lbalucos/Wilamp_DCU/mft/pcb/Controlled impedance/Top90.PNG

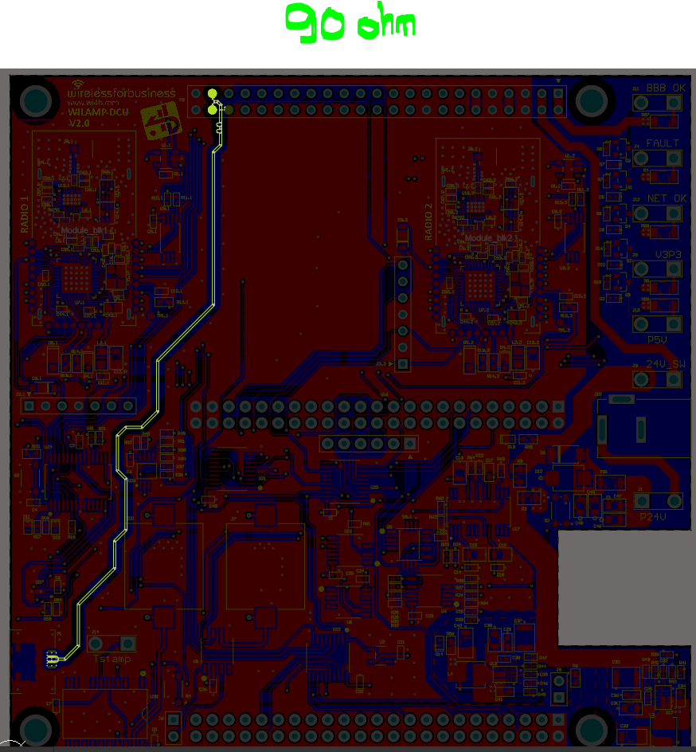
mft/pcb/Controlled impedance/Top90.PNG
