lbalucos/Wilamp_DCU/(threads)

Thread 1 (2022-04-07):

HW_CR1: remove components

lbalucos, 2022-04-07:
For the next batch we will not mount these components (we do not find equivalent):

- ATAES132A-SHER-B
- 24LC256T-I/SN
- ATECC108A-SSHDA
- AT97SC3205T-X3A1C-10

lbalucos, 2022-04-08:
-ATAES132A-SHER-B set as DNP
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

-24LC256T-I/SN set as DNP
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

-ATECC108A-SSHDA set as DNP
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

-AT97SC3205T-X3A1C-10 set as DNP
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

-MCP9808T-E/MS set as DNP
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

-24LC32AT-I/OT set as DNP
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

-PCF2129AT/2,518 set as DNP
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

Thread 2 (2022-04-07):

HW_CR2: find ALT PN on all components used

lbalucos, 2022-04-07:
For all the others components it is necessary to find an alternative, or the device will not work!

arthur-asodisen, 2022-04-16:
What is the kind of help needed?

lbalucos, 2022-04-18:
i need help finding alternate MPNs on some of the components
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

[Wilamp DCU ALT MPN (no DNP).xlsx](https://github.com/lbalucos/Wilamp_DCU/files/8506817/Wilamp.DCU.ALT.MPN.no.DNP.xlsx)

lbalucos, 2022-04-22:
NUD3124LT1G labeled as no stock

[Wilamp DCU ALT MPN (no DNP).xlsx](https://github.com/lbalucos/Wilamp_DCU/files/8541909/Wilamp.DCU.ALT.MPN.no.DNP.xlsx)

arthur-asodisen, 2022-04-22:
Ilist ang mga nakitan nimo nga alt parts para diretso rako check. Limitwd
kaayo akong time.

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

Thread 3 (2022-04-07):

HW_CR3: PCB Form factor, Header/connector position fixed

lbalucos, 2022-04-07:
Starting from the latest version released:
**Wilamp_DCU_v1.1 rls 20190123**
keeping the same PCB form factor and position of the headers and connectors, as a first step we require

Thread 4 (2022-04-07):

HW_CR4: replace the JN5168-M06 modules with the JN5169 chip

lbalucos, 2022-04-07:
- replace the JN5168-M06 modules with the JN5169 chip and the other necessary boundary components directly on the PCB, as done for the WiSZ and in the DCU_CM4_DINRAIL project. Maintains the u.FL connector for external antenna connection.

lbalucos, 2022-04-12:
JN5168-M06 module replaced with JN5169 chip
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

arthur-asodisen, 2022-04-16:
What kind of help needed?

lbalucos, 2022-04-18:
mislabeled, it should be for review only.

latest PCB update
Routing Complete
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

Thread 7 (2022-04-07):

HW_CR7:  JN5168 module #3 and all its components can be put in DNP or removed

lbalucos, 2022-04-07:
In this revision the JN5168 module #3 and all its components can be put in DNP.
Then in subsequent releases, if space is needed on the PCB in order to add other equivalent components with a larger package
or to have space to house the double footprint of critical components, to have more chances to find them in stock, we can remove the Module #3.

lbalucos, 2022-04-08:
Jennic 3 components marked as DNP
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

lbalucos, 2022-04-12:
Jennic module 3 removed since there is no space for traces
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
