lbalucos/Wilamp_DCU/pdf/Wilamp DCU v2.0.pdf

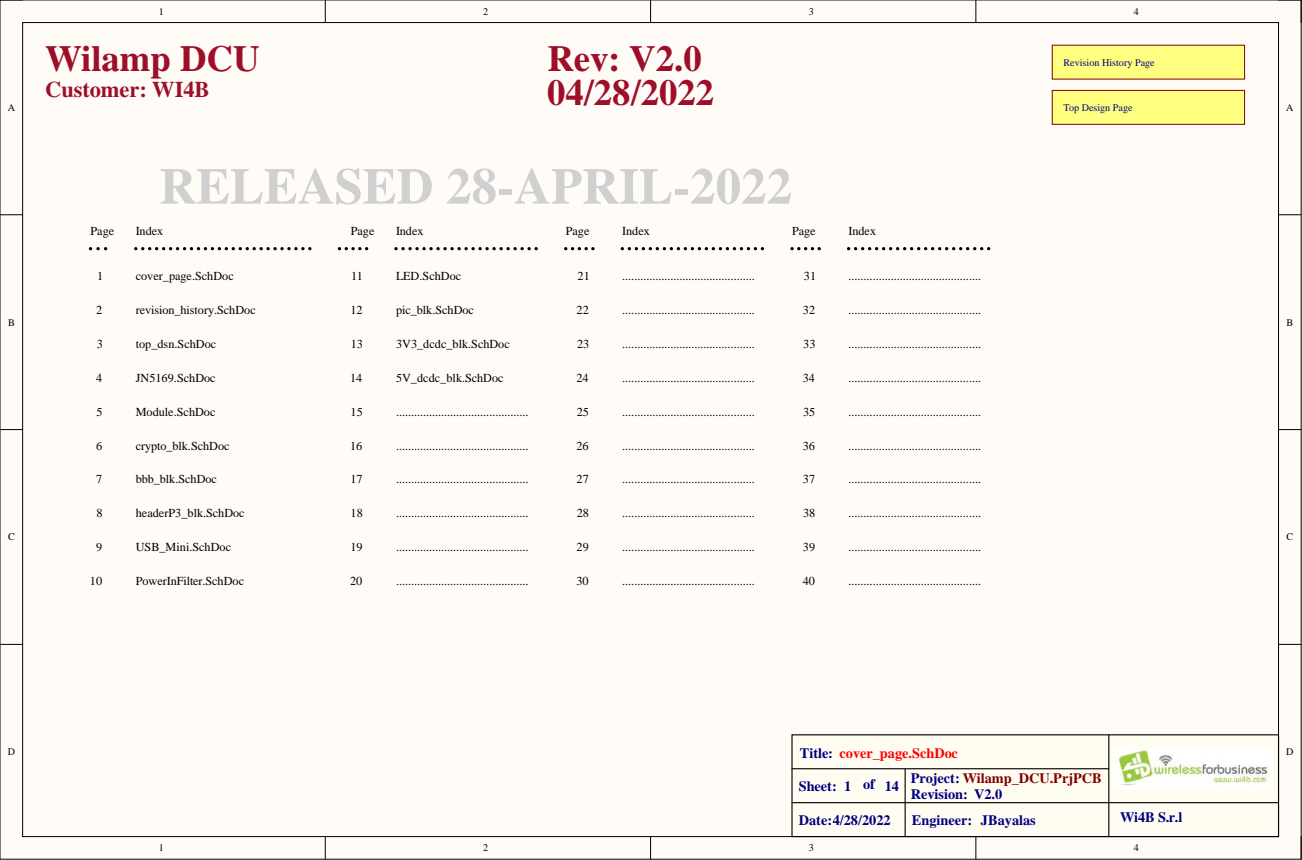
[picture p2: page 1]

Title: cover_page.SchDoc

Sheet: 1 of 14 | Project: Wilamp_DCU.PrjPCB Revision: V2.0

Date:4/28/2022 | Engineer: JBayalas | Wi4B S.r.l

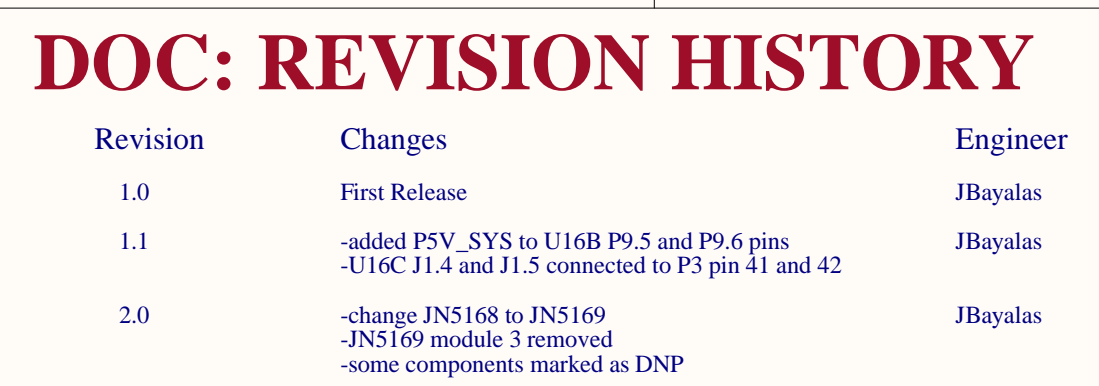
[picture p3: page 2]

-U16C J1.4 and J1.5 connected to P3 pin 41 and 42

-some components marked as DNP

Title: revision_history.SchDoc

Sheet: 2 of 14 | Project: Wilamp_DCU.PrjPCB Revision: V2.0

JBayalas

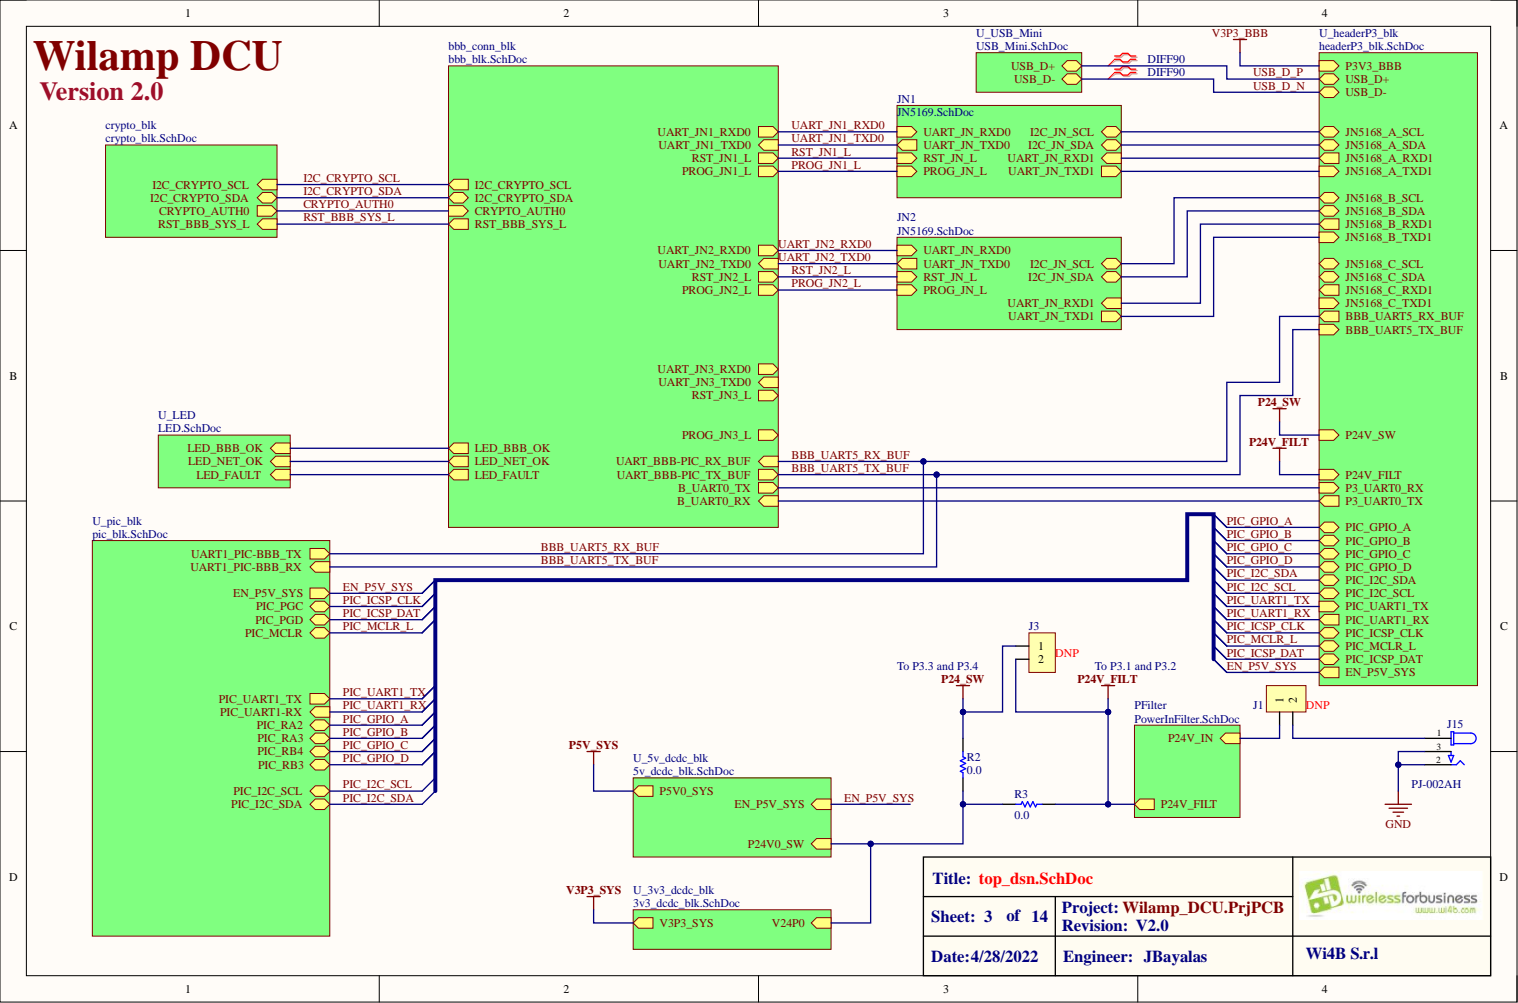
[picture p4: page 3]

UA RT_BBB-PIC_TX_BUF | BBB_UA RT5_TX_BUF

o f 14 Sheet: 3 | Project: Wilamp_DCU.PrjPC B Revision : V2.0

JBayal a s

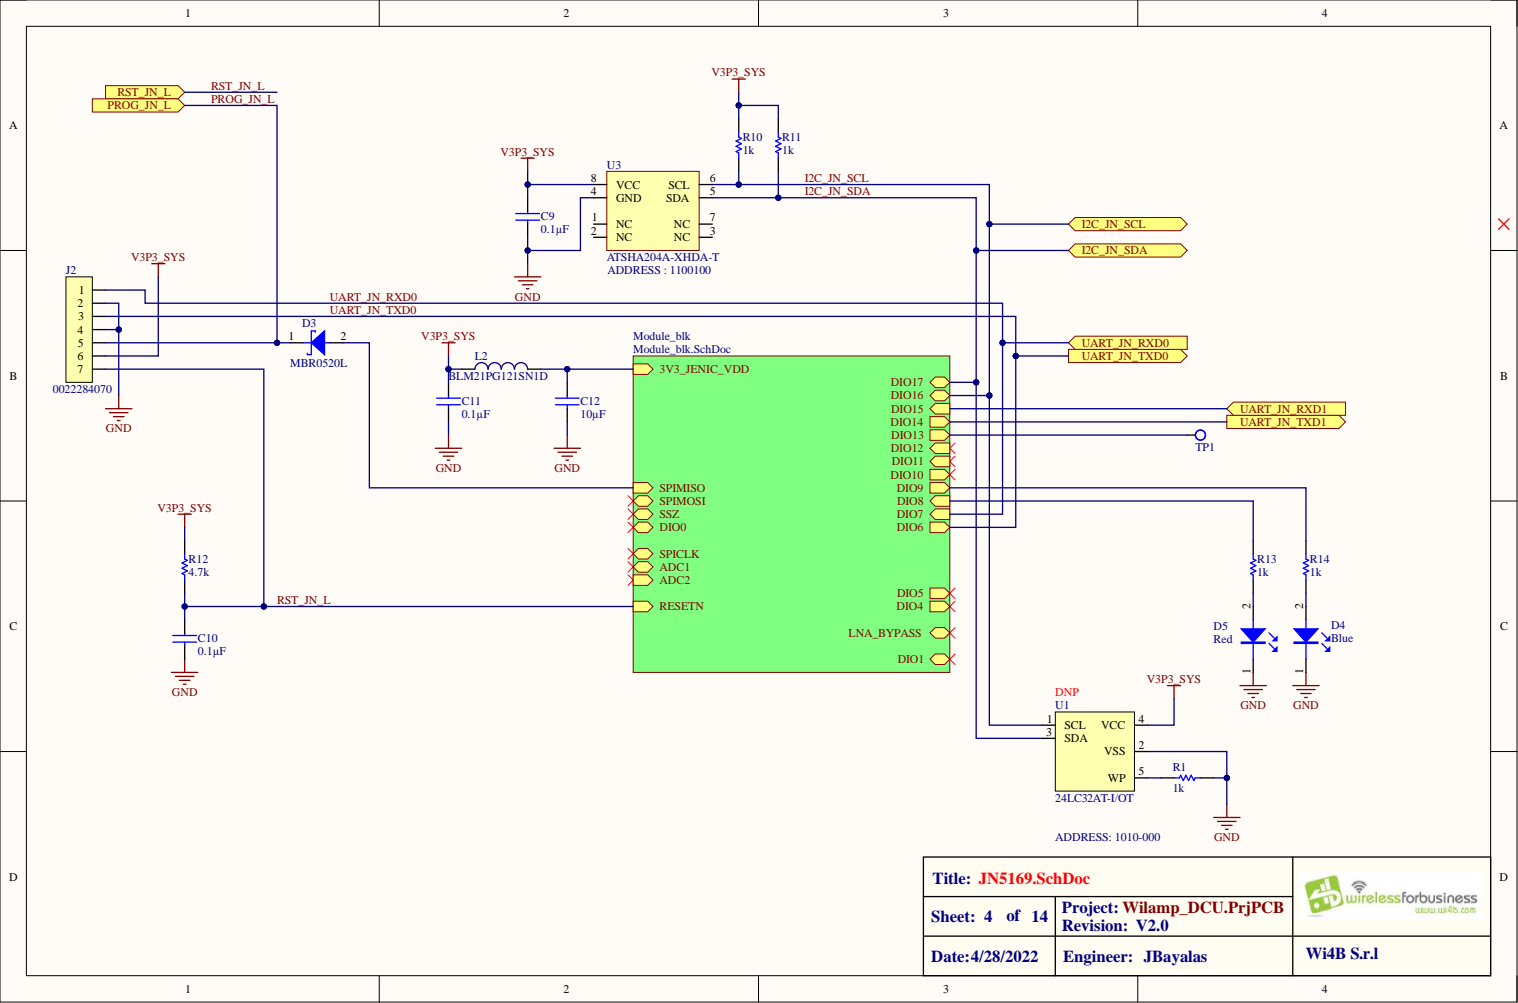
[picture p5: page 4]

I2C_JN_SDA

UART_JN_TXD0
D3

Title: JN5169.SchDoc

Sheet: 4 of 14 | Project: Wilamp_DCU.PrjPCB Revision: V2.0

JBayalas

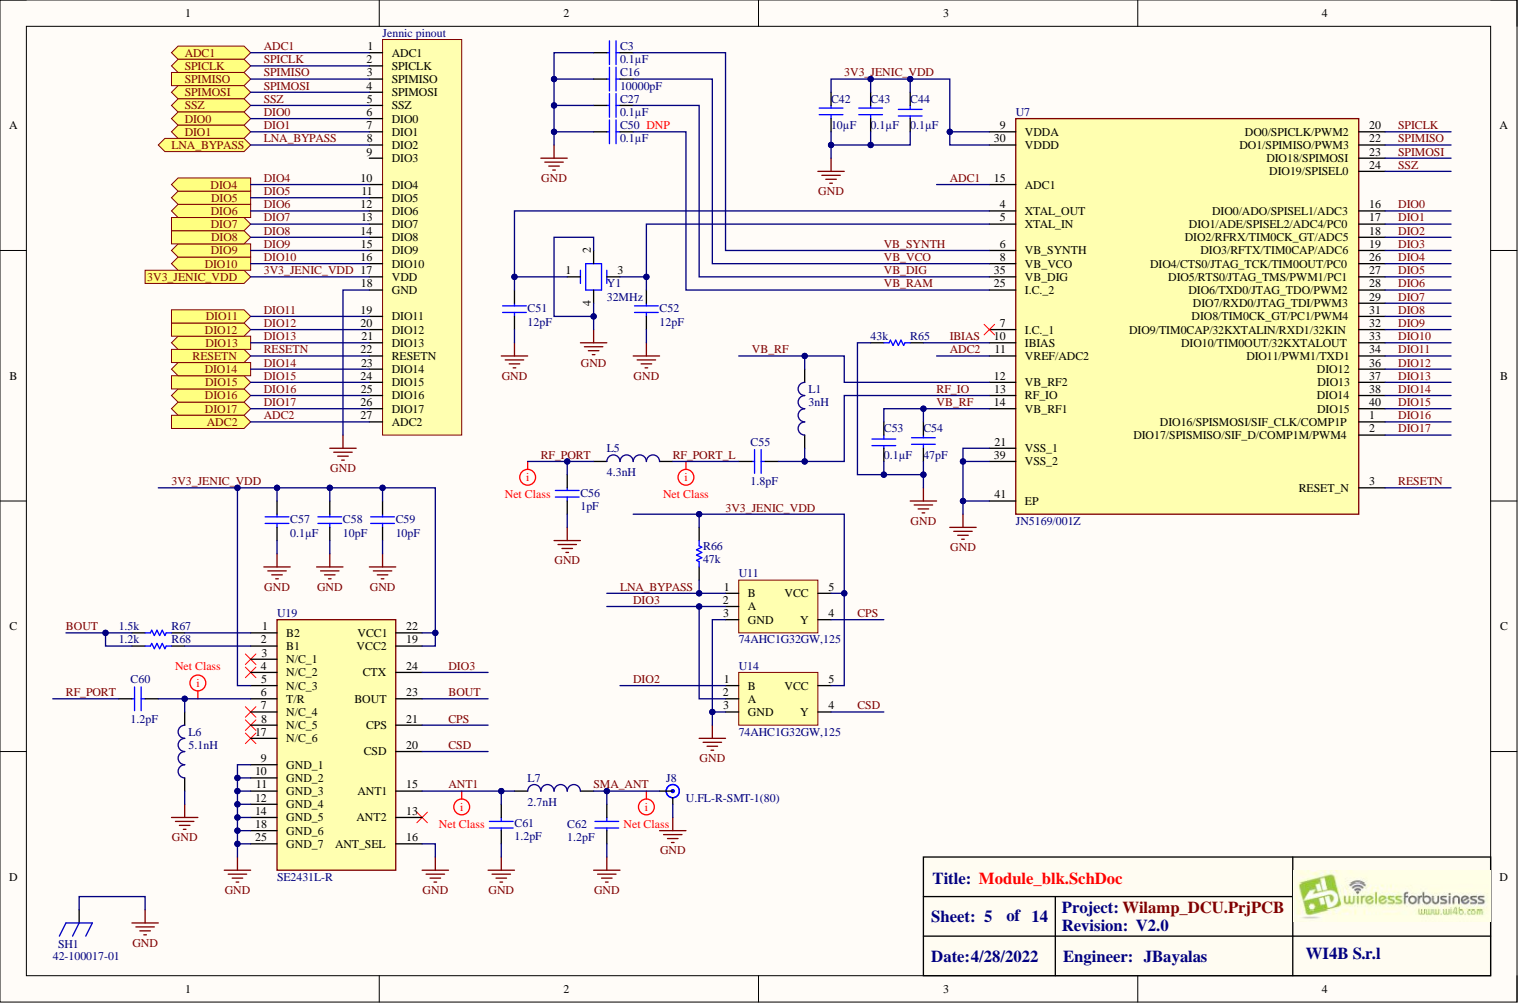
[picture p6: page 5]

0.1 C16 | µ F 3V3_JENIC_VDD

RESETN SPICLK SPIMISO SPIMOSI SSZ

Title: Module_blk.SchD o c

o f 14 Sheet: 5 | Project: Wilamp_DCU.PrjPC B

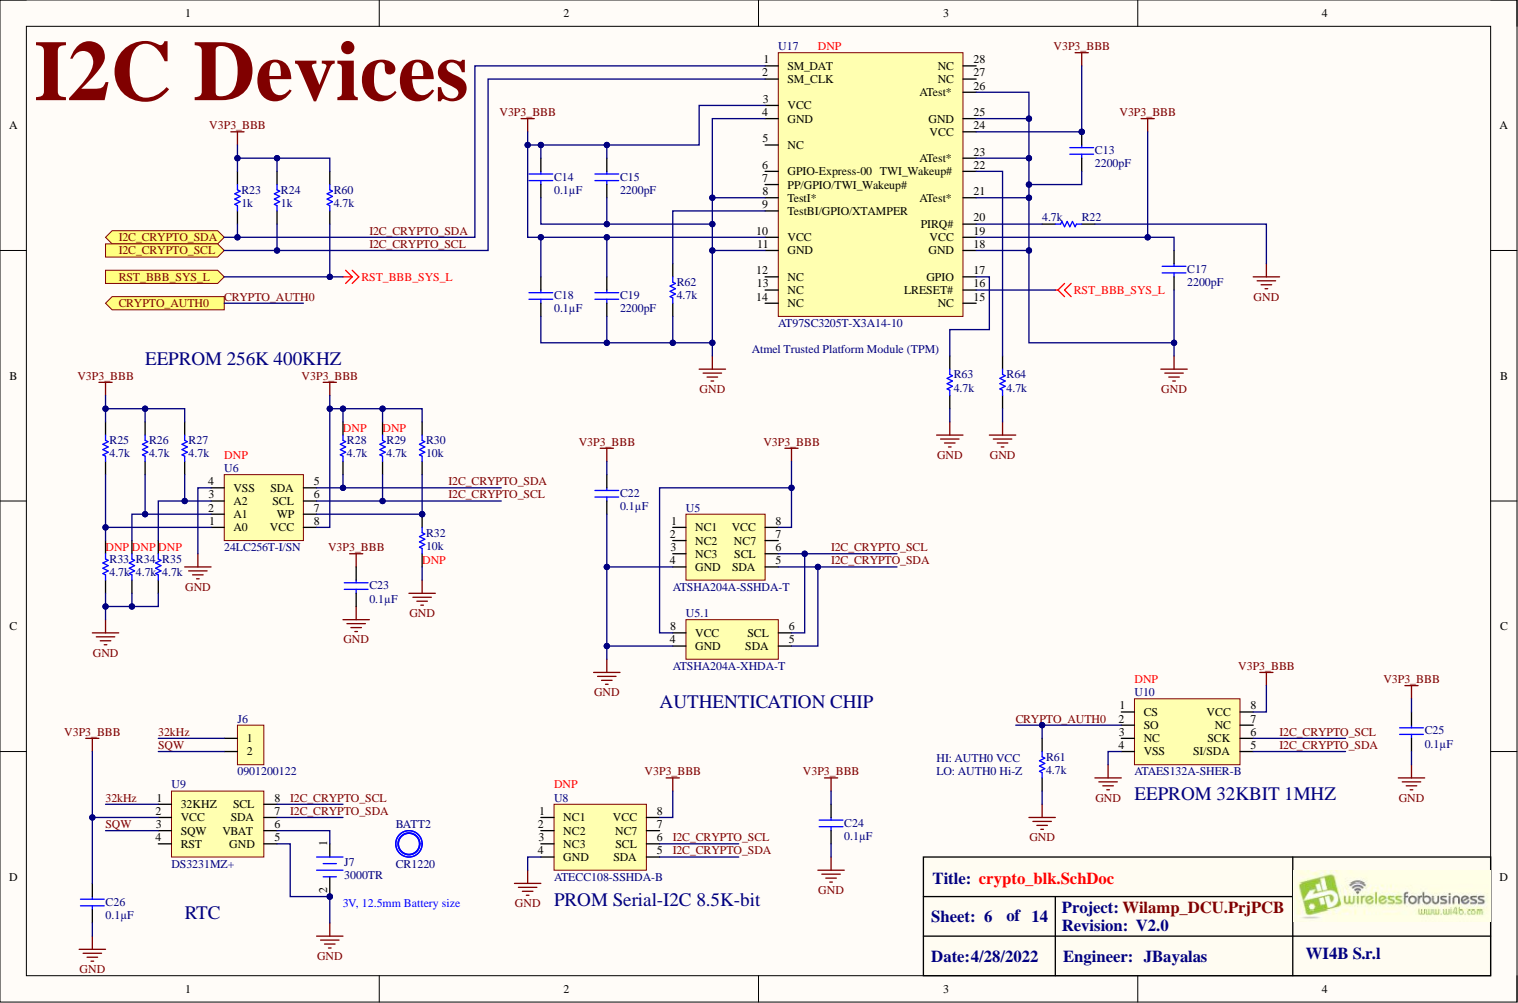
[picture p7: page 6]

Atmel Trusted Platform Module (TPM)

Title: crypto_blk.SchD o c

o f 14 Sheet: 6 | Project: Wilamp_DCU.PrjPC B

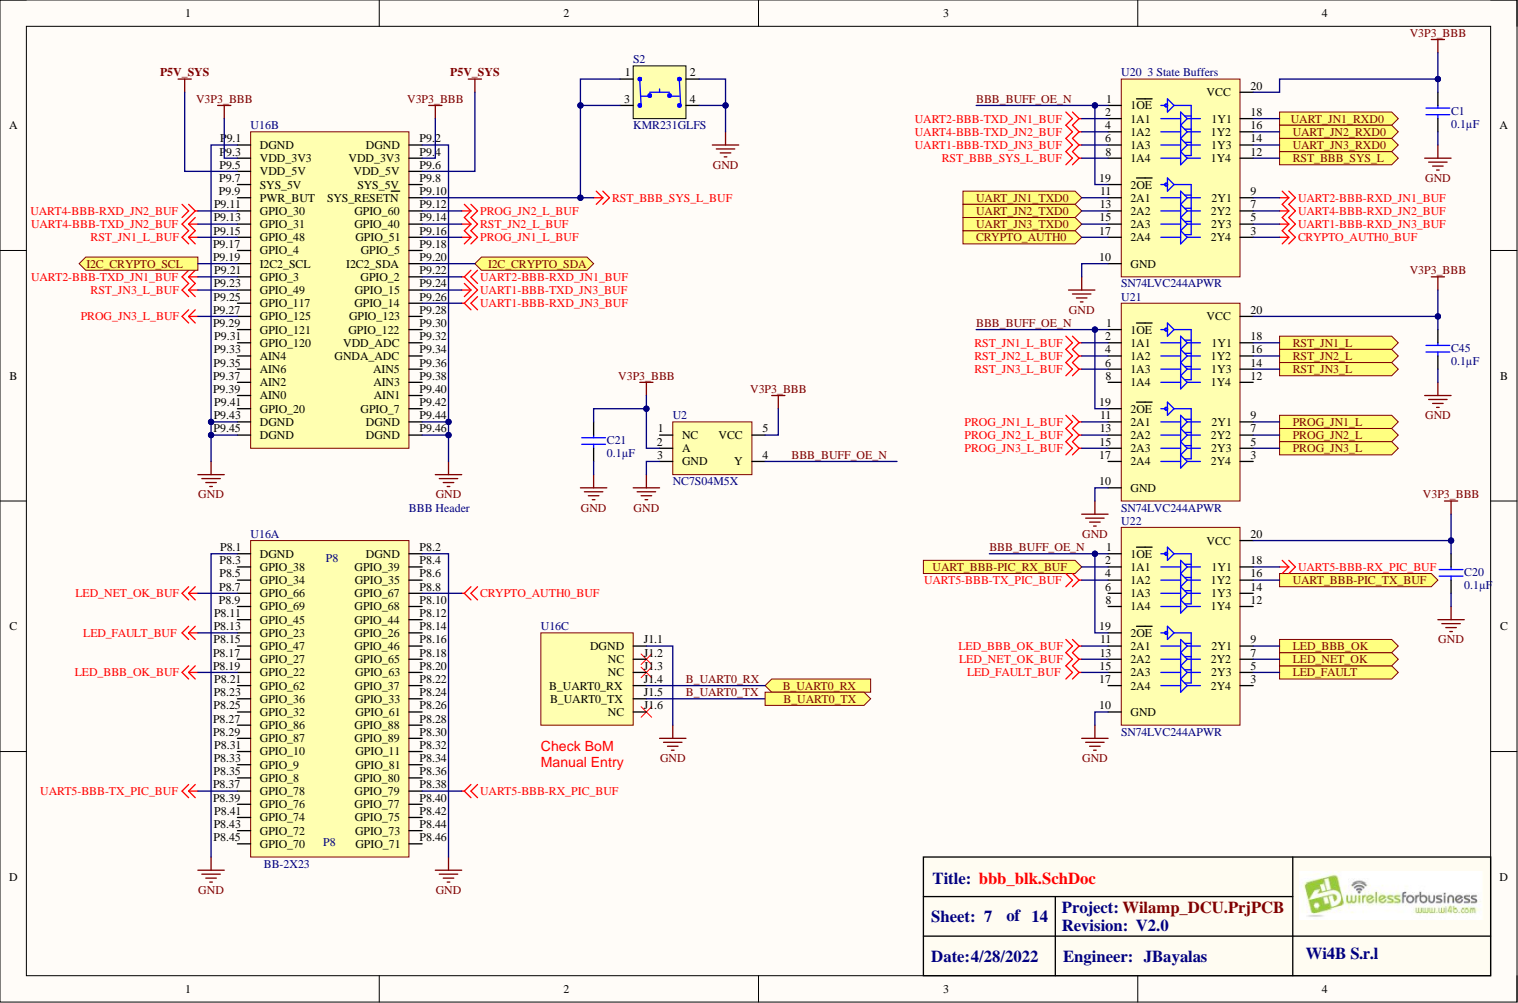
[picture p8: page 7]

1A2 4
1A3 6
1A4 8

Title: bbb_blk.SchDoc

Sheet: 7 of 14 | Project: Wilamp_DCU.PrjPCB Revision: V2.0

JBayalas

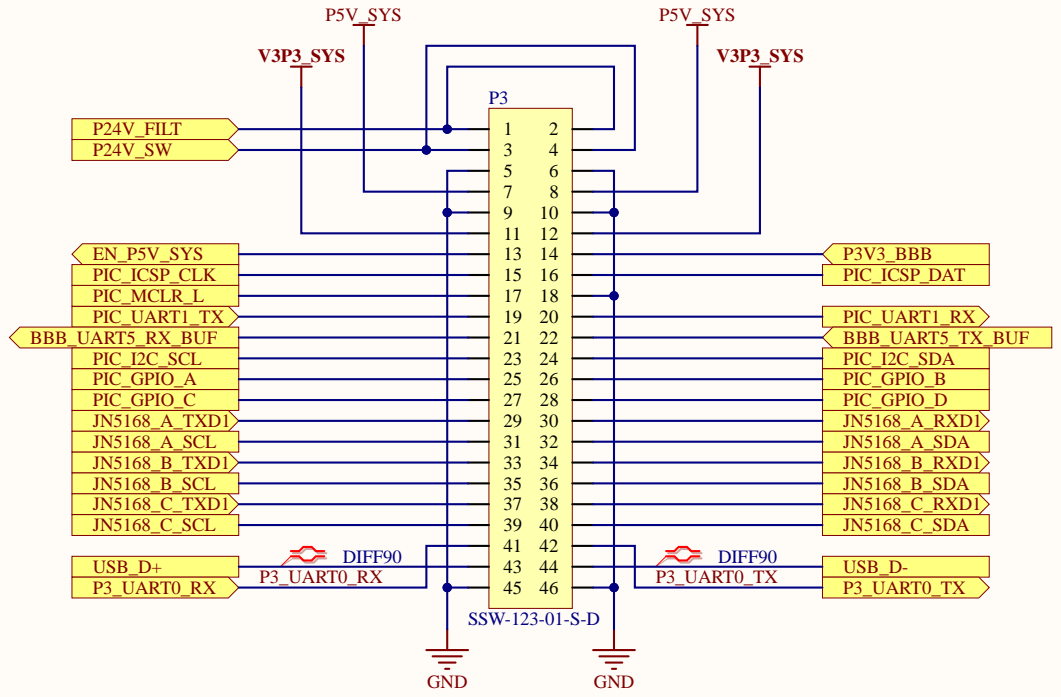
[picture p9: page 8]

DIFF90 | DIFF90

Title: headerP3_blk.SchDo c

o f 14 Sheet: 8 | Project: Wilamp_DCU.PrjPC B

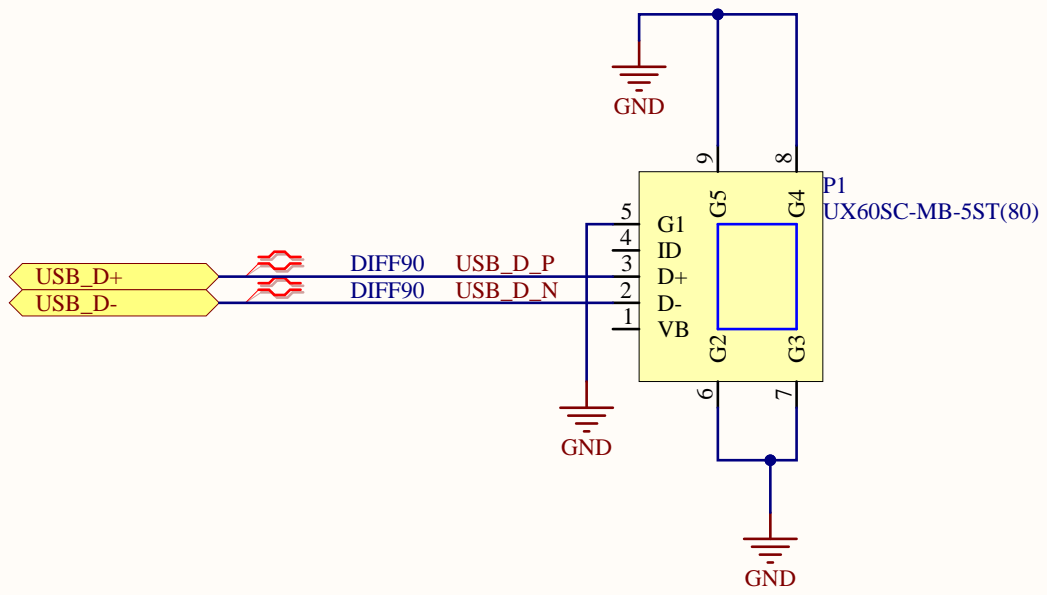
[picture p10: page 9]

Title: USB_Mini.SchD o c

o f 14 Sheet: 9 | Project: Wilamp_DCU.PrjPC B

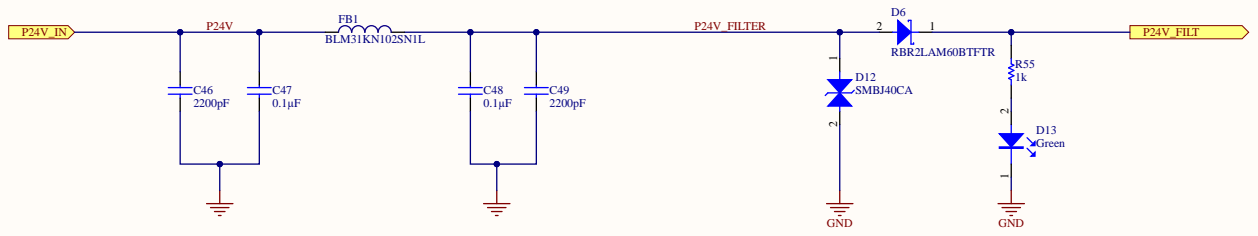
[picture p11: page 10]

Title: PowerInFilter.SchD o c

o f 14 Sheet: 10 | Project: Wilamp_DCU.PrjPC B

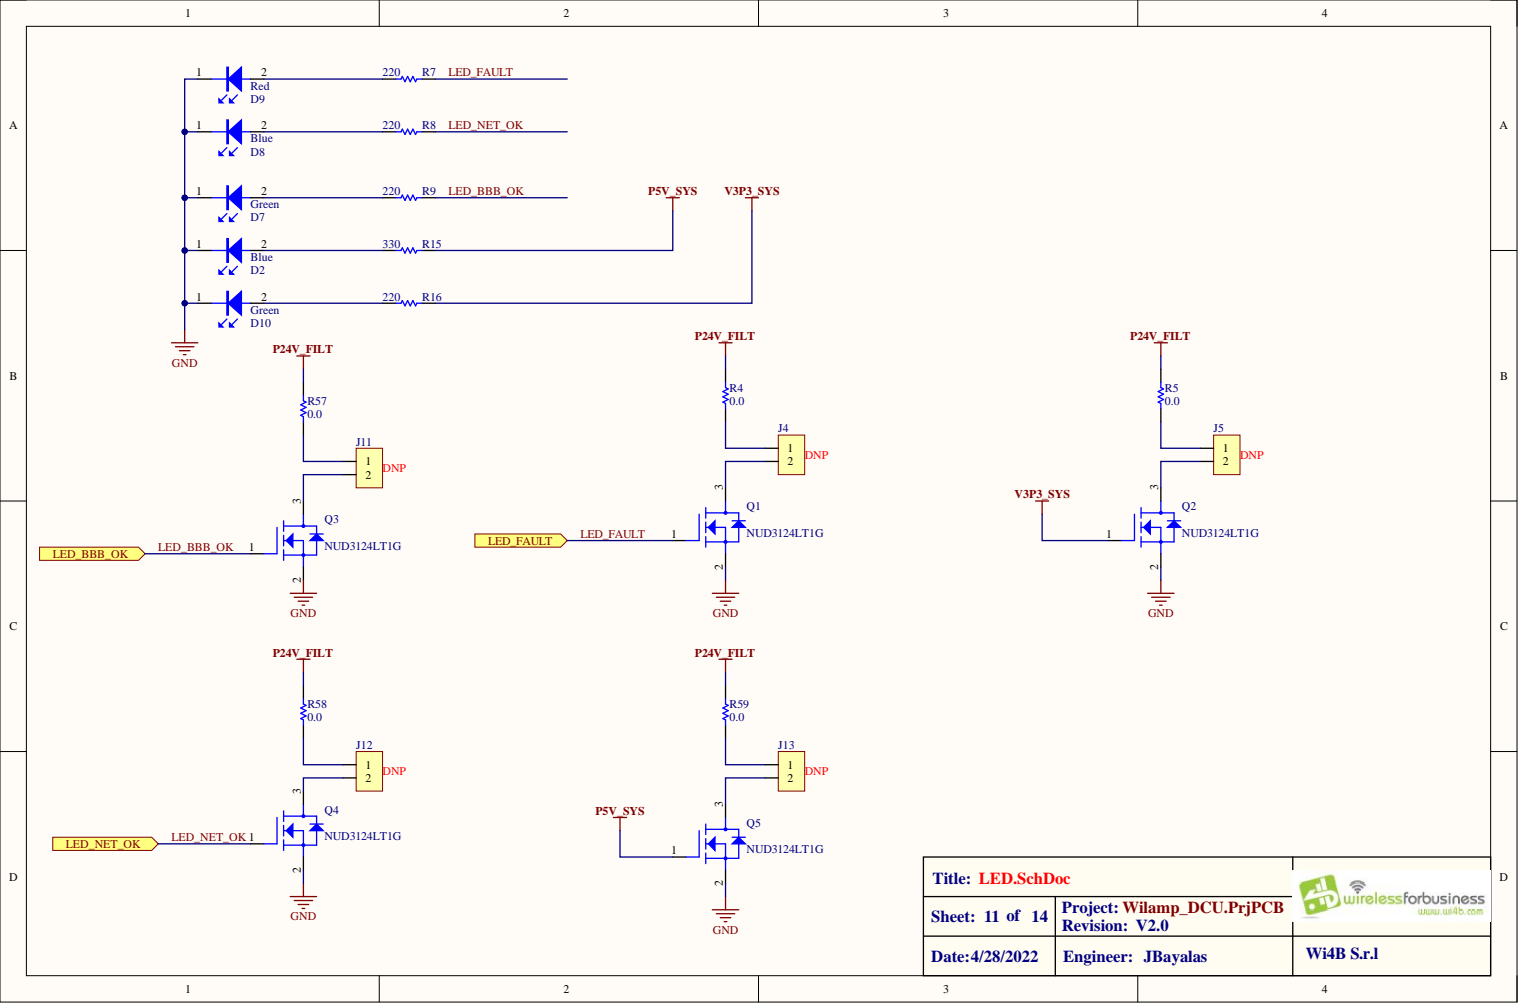
[picture p12: page 11]

Title: LED.SchD o c

o f 14 Sheet: 1 1 | Project: Wilamp_DCU.PrjPC B

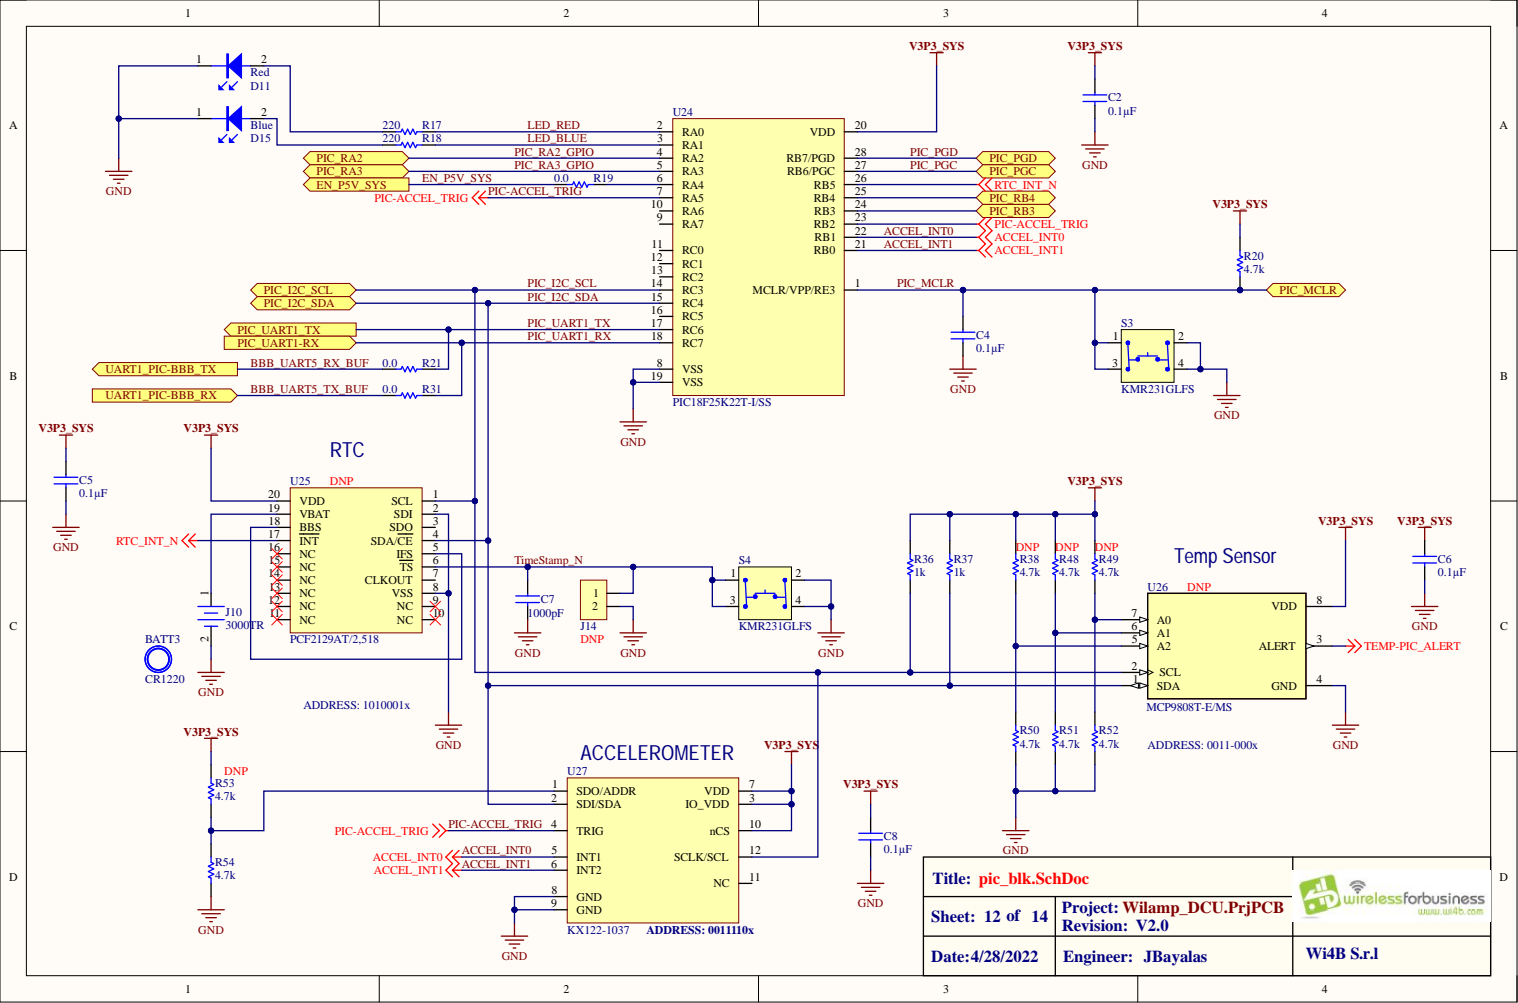
[picture p13: page 12]

SDA 1 SCL 2

ACCELEROMETER U27 | V3P3_SYS

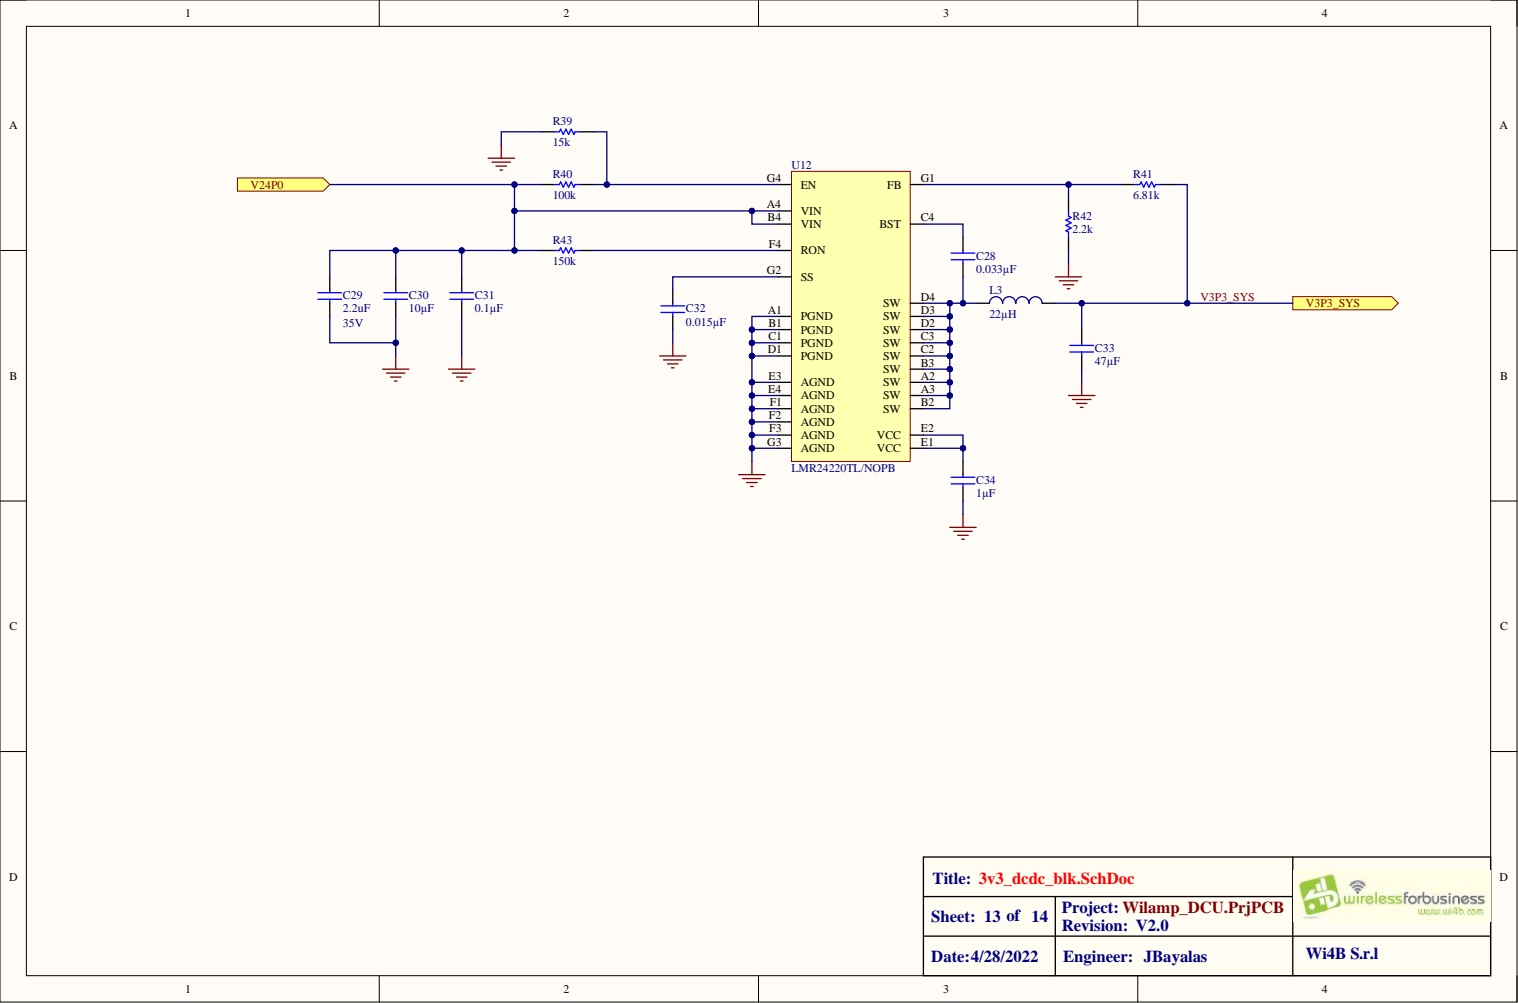
[picture p14: page 13]

Title: 3v3_dcdc_blk.SchDo c

o f 14 Sheet: 13 | Project: Wilamp_DCU.PrjPC B

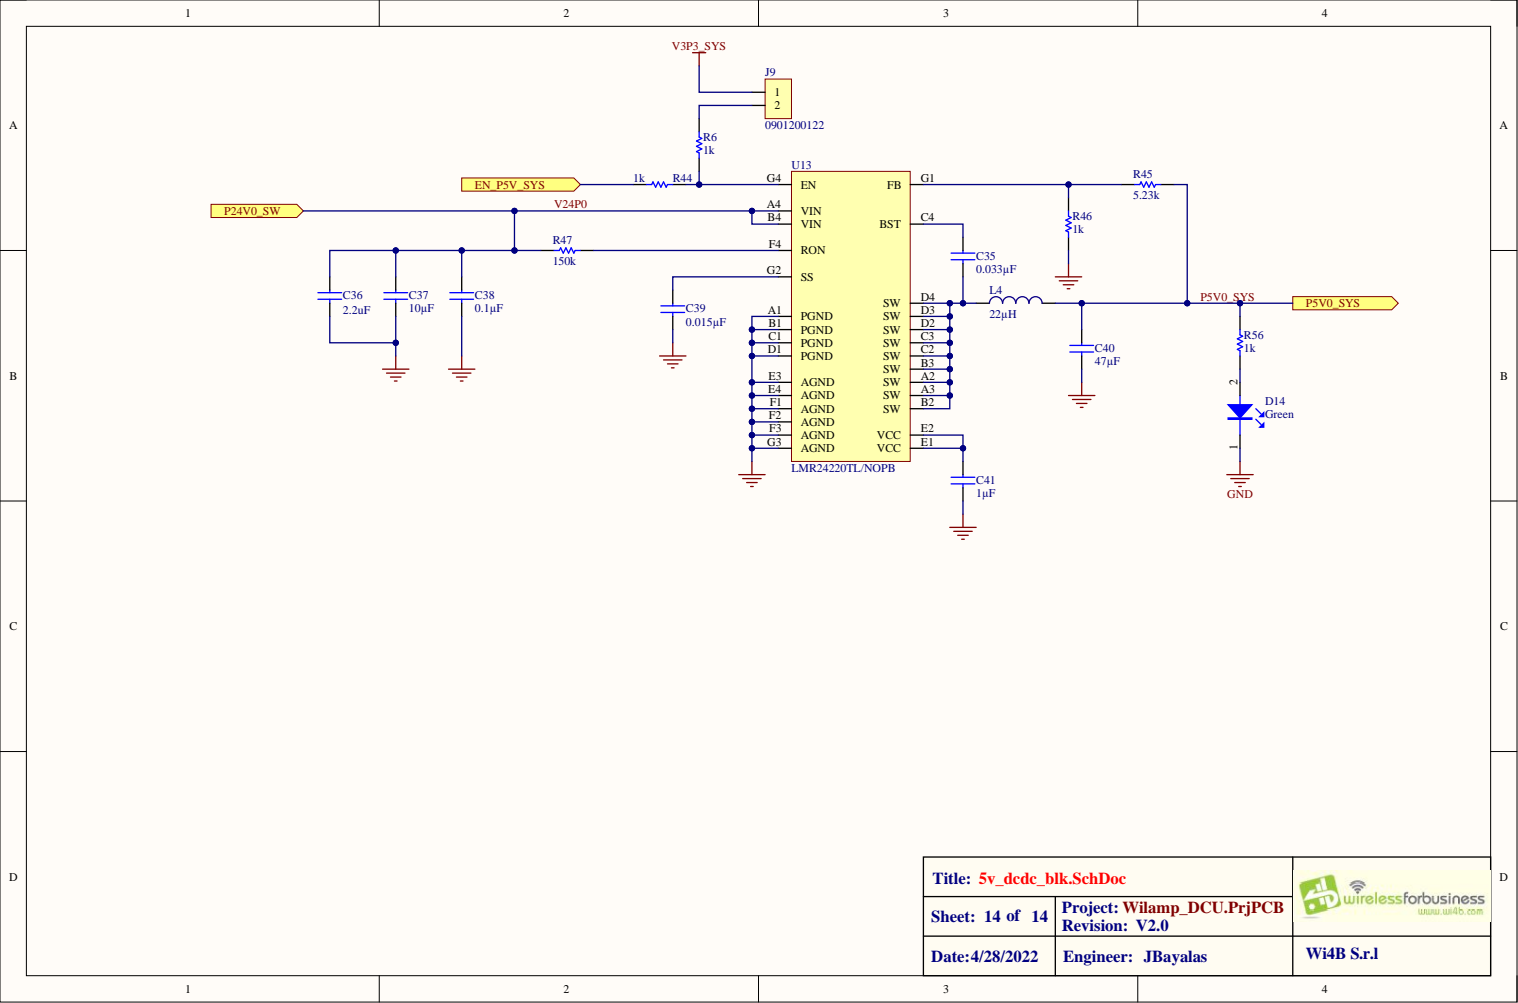
[picture p15: page 14]

Title: 5v_dcdc_blk.SchDo c

o f 14 Sheet: 14 | Project: Wilamp_DCU.PrjPC B
