lbalucos/Wilamp_DCU/mech/3D Wilamp DCU v2.0.pdf

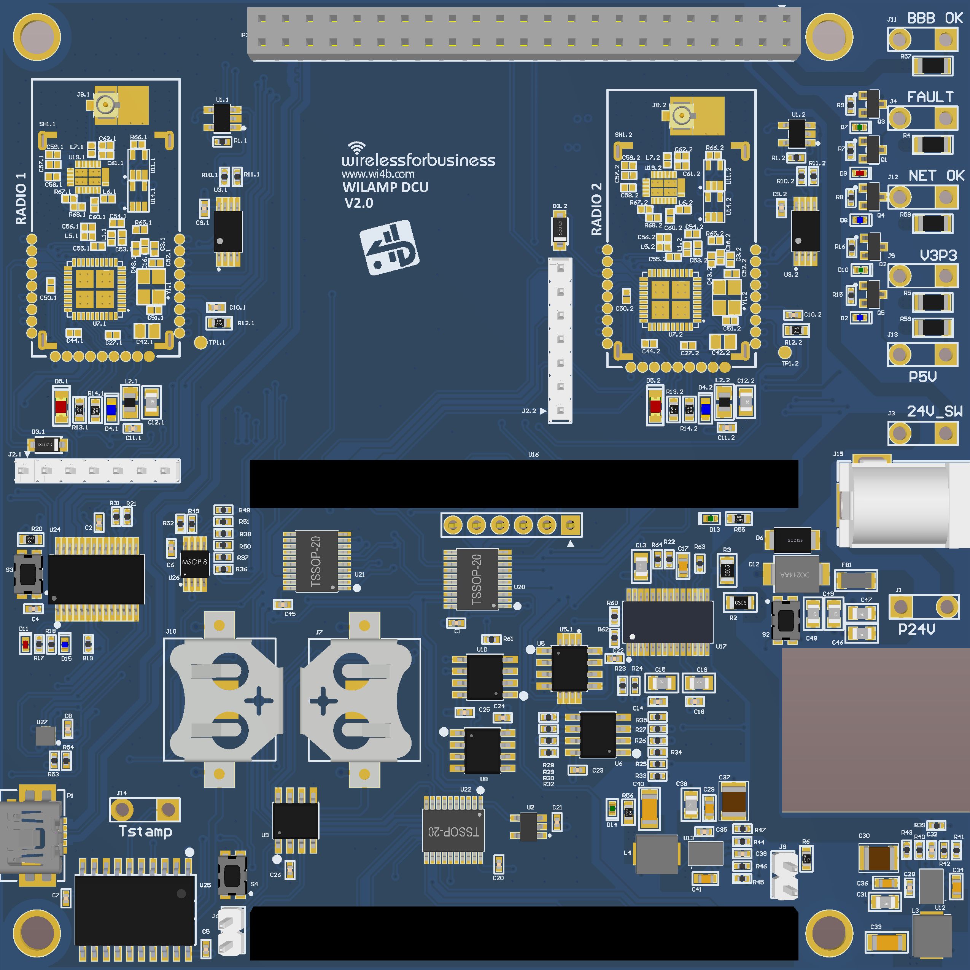
[picture p16: page 1]

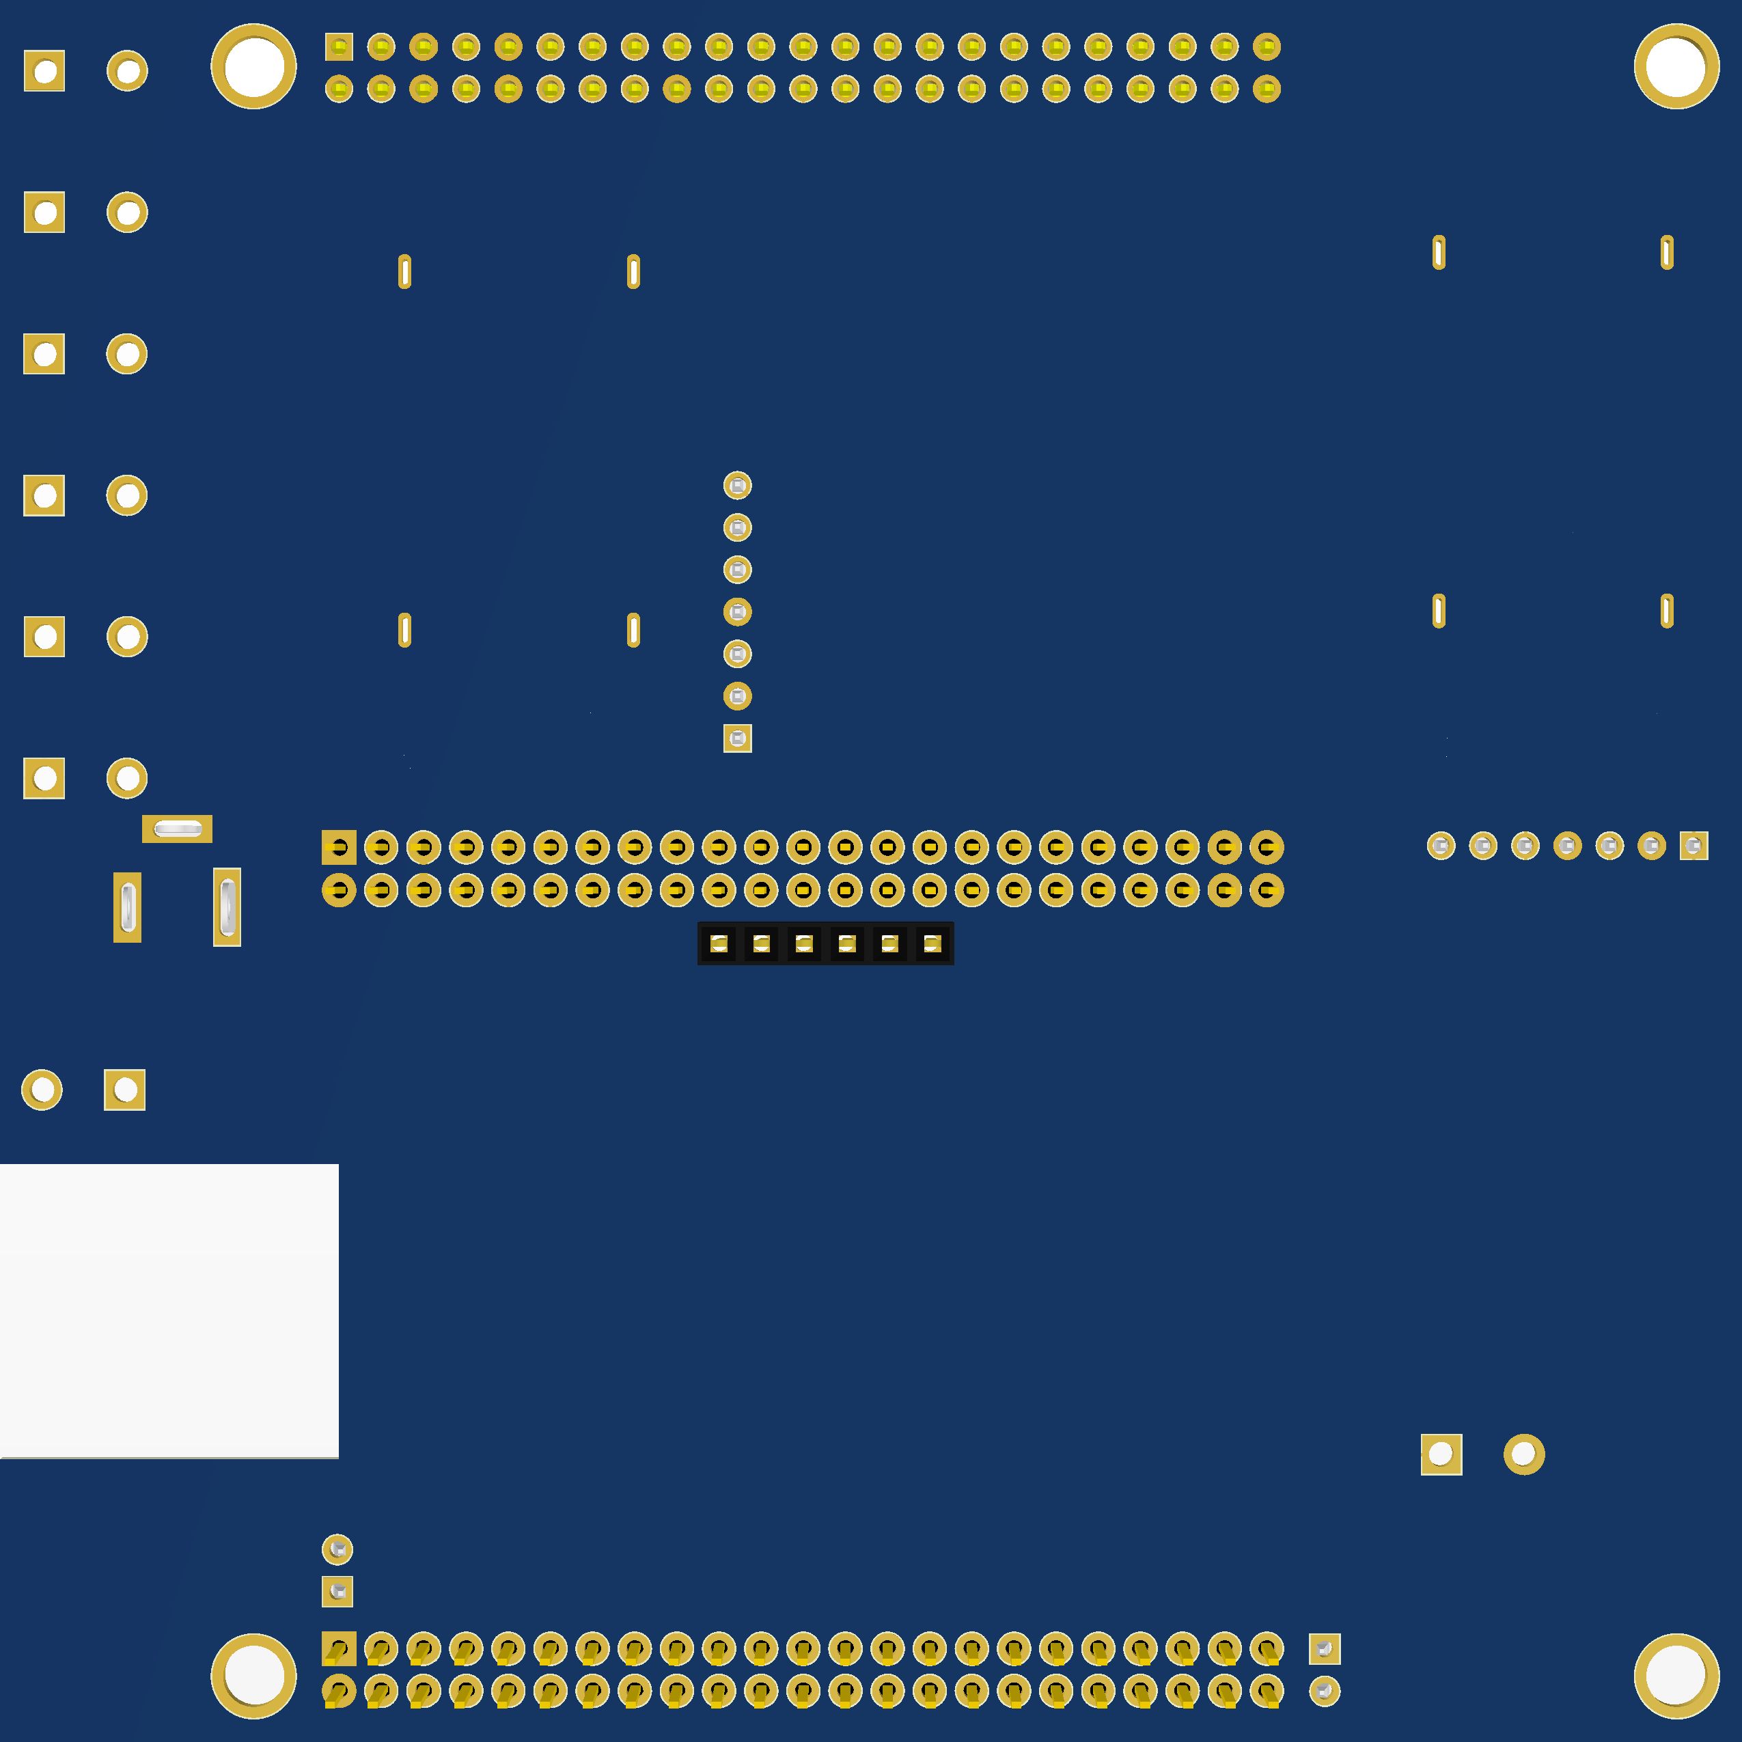
[picture p17: page 2]
