lbalucos/Wilamp_DCU/mech/Mech Wilamp DCU v2.0.pdf

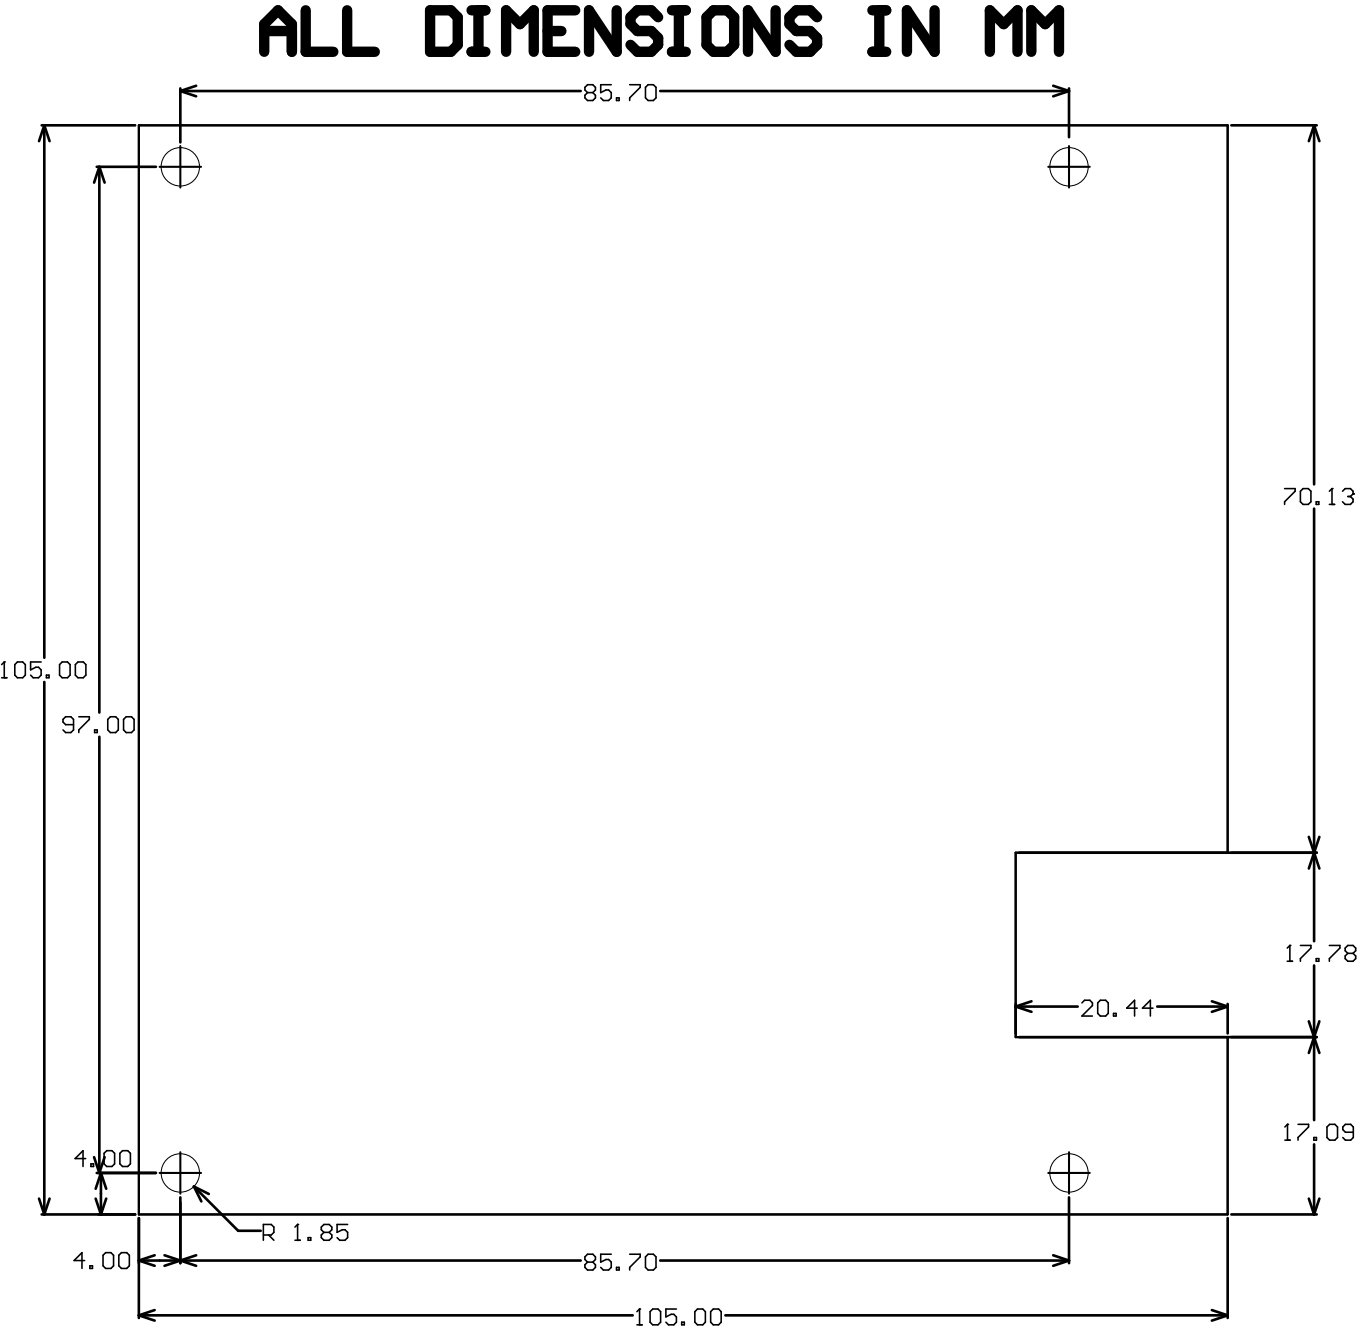
[picture p18: page 1]
