lbalucos/Wilamp_DCU/mft/Gerber.pdf

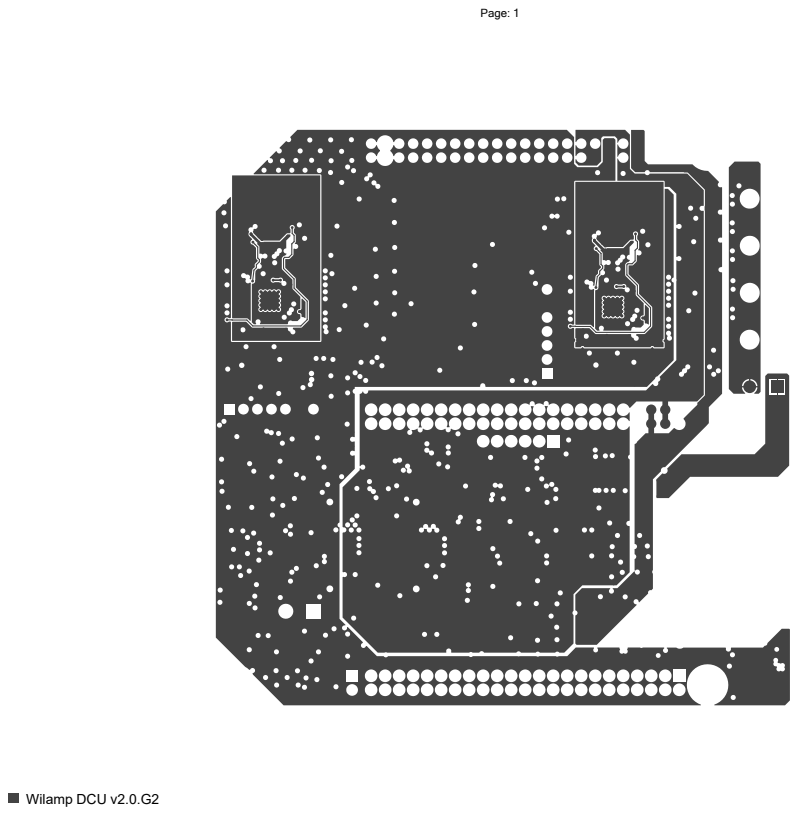
[picture p19: page 1]
Wilamp DCU v2.0.G2

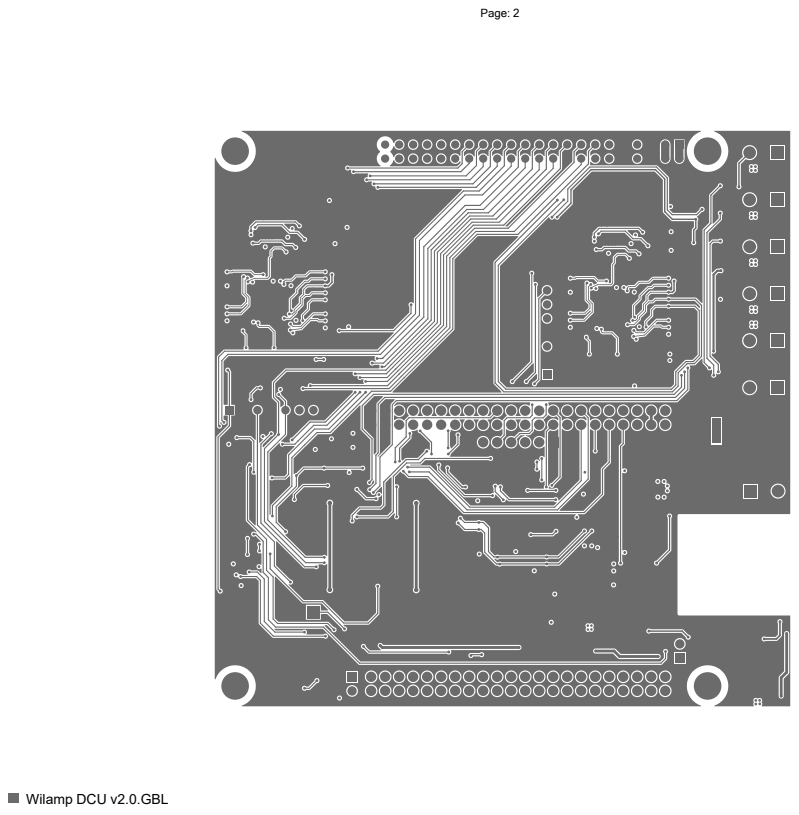
[picture p20: page 2]

Wilamp DCU v2.0.GBL

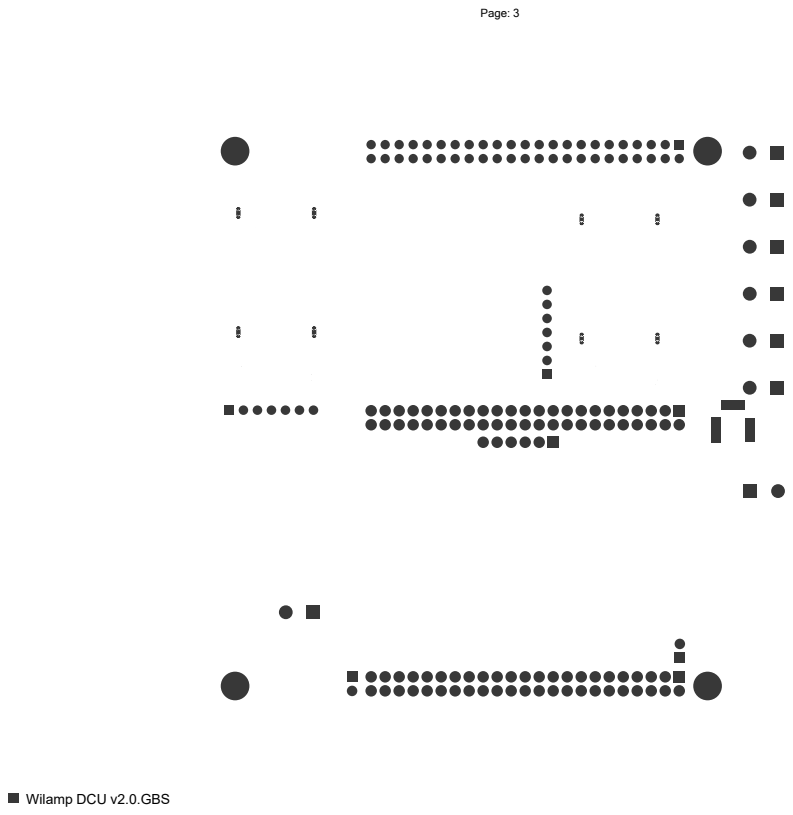
[picture p21: page 3]

Wilamp DCU v2.0.GBS

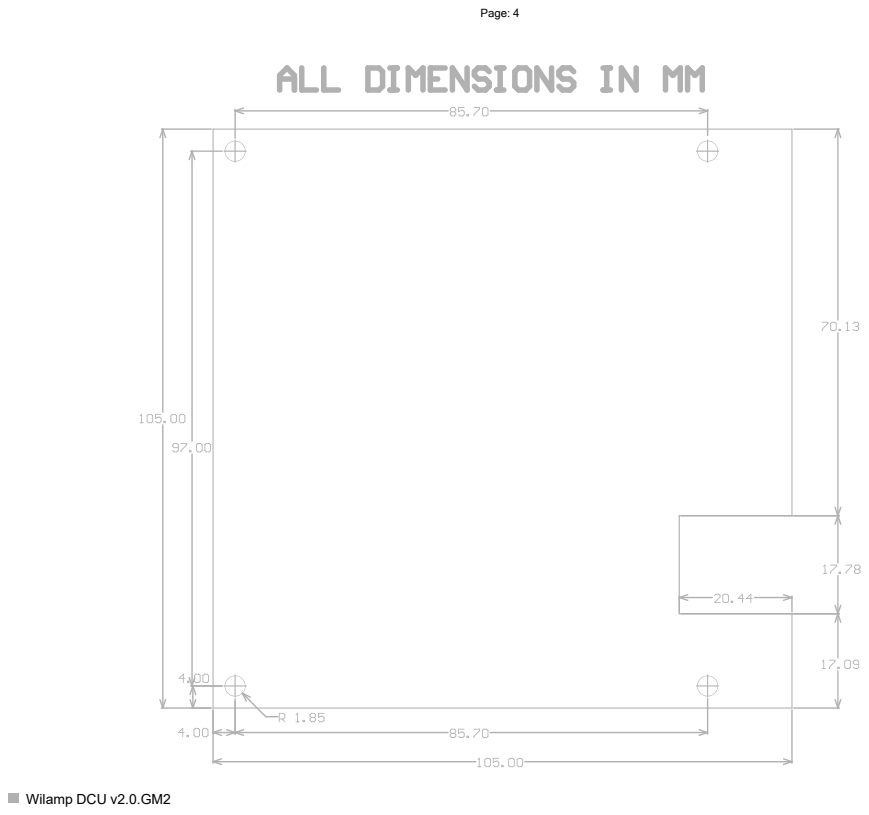
[picture p22: page 4]
Wilamp DCU v2.0.GM2

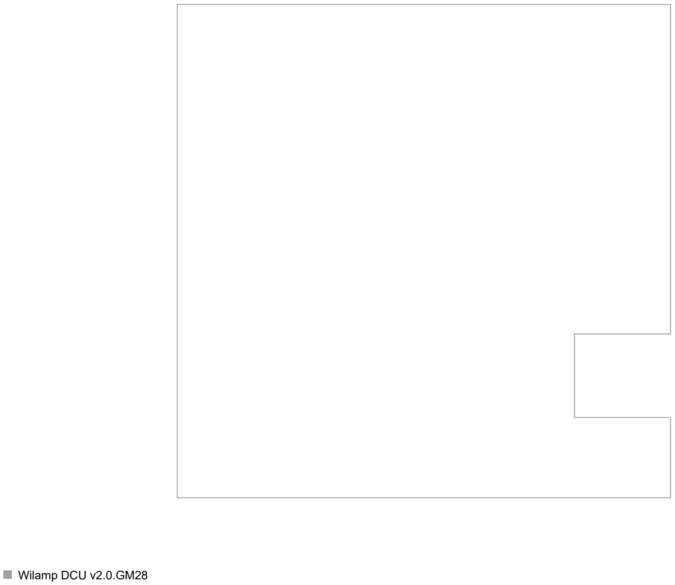
[picture p23: figure]
Wilamp DCU v2.0.GM28
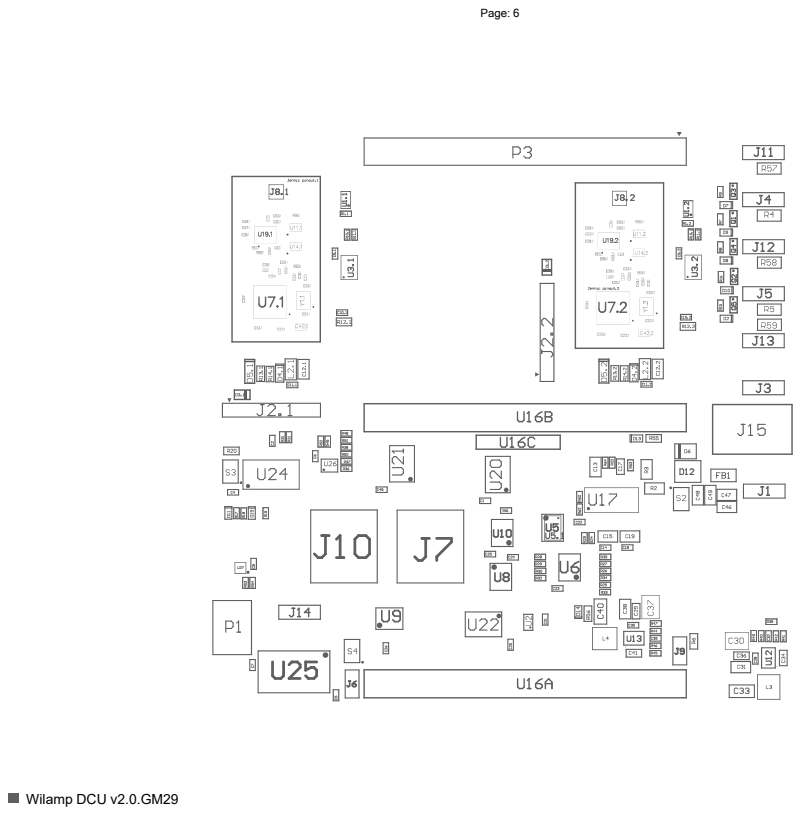
[picture p24: page 6]
Wilamp DCU v2.0.GM29

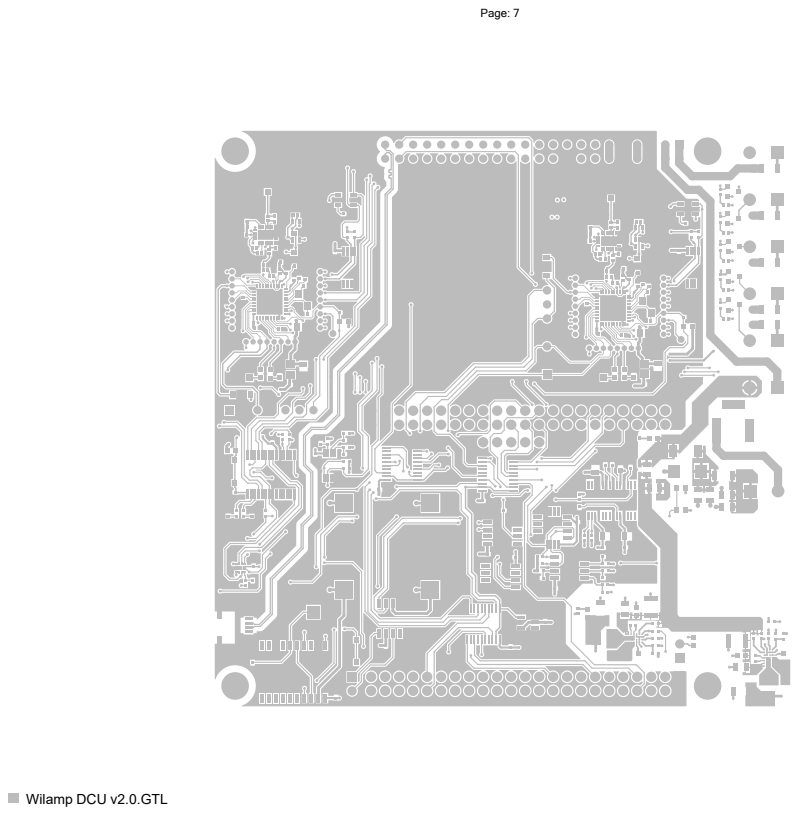
[picture p25: page 7]

Wilamp DCU v2.0.GTL

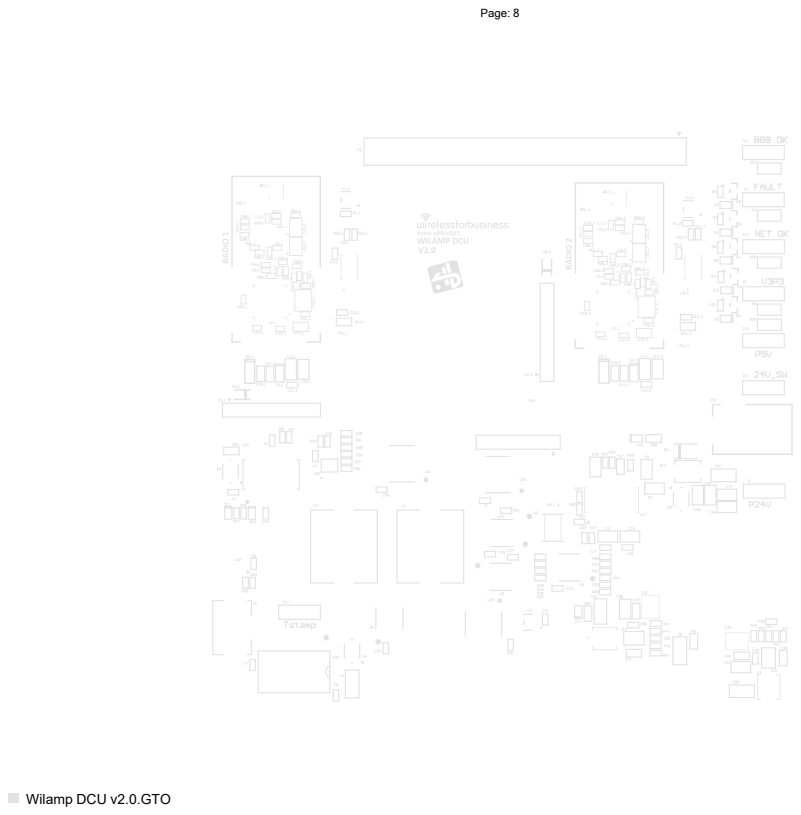
[picture p26: page 8]

Wilamp DCU v2.0.GTO

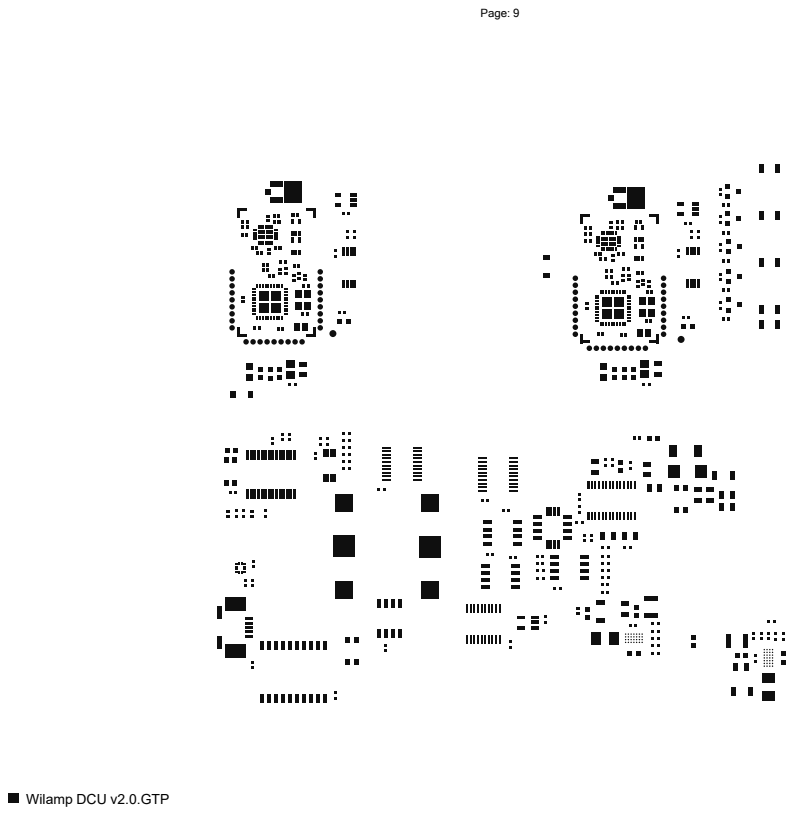
[picture p27: page 9]

Wilamp DCU v2.0.GTP

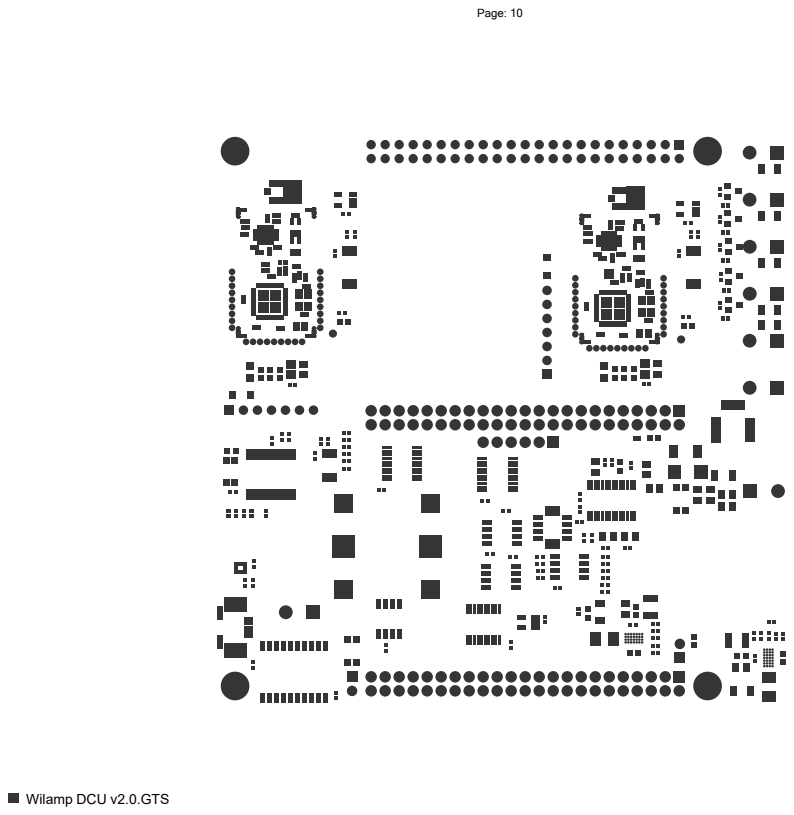
[picture p28: page 10]

Wilamp DCU v2.0.GTS

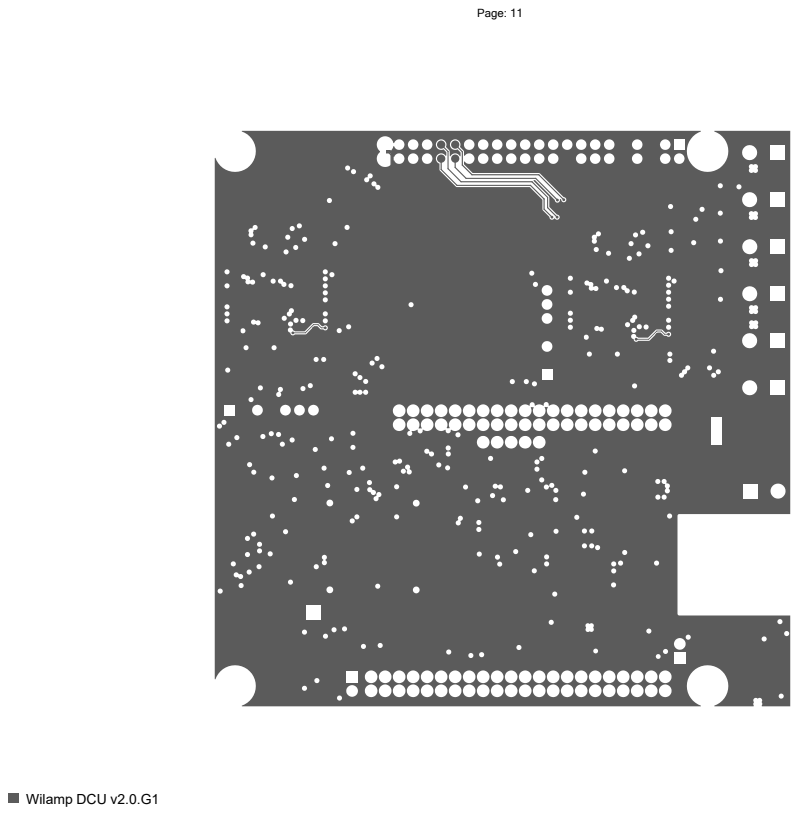
[picture p29: page 11]
Wilamp DCU v2.0.G1

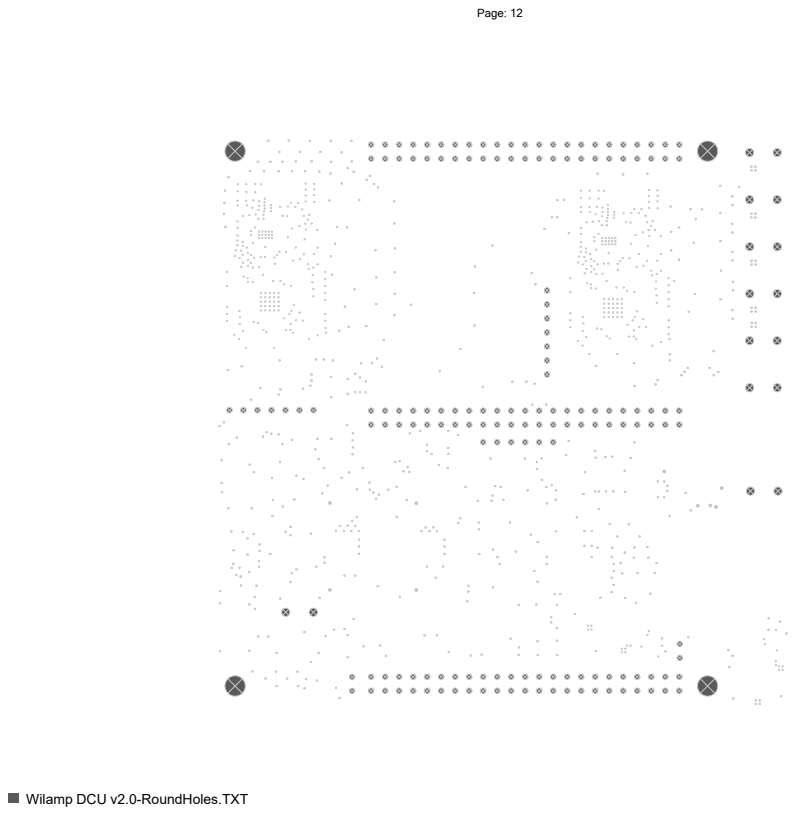
[picture p30: page 12]

Wilamp DCU v2.0-RoundHoles.TXT
