lbalucos/Wilamp_DCU/mft/pca/Assm Wilamp DCU v2.0.pdf

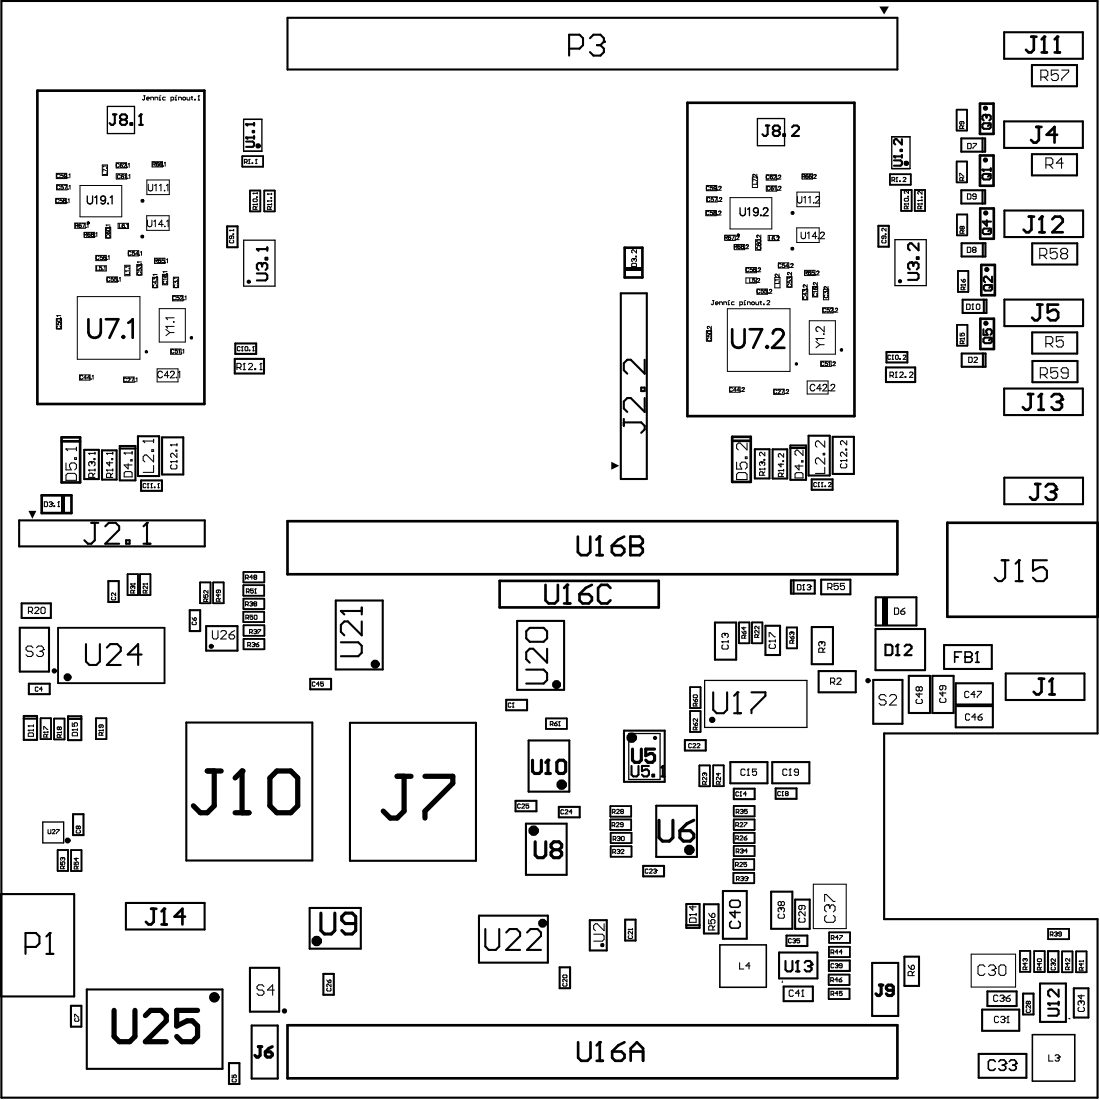
[picture p31: page 1]
