lbalucos/Wilamp_DCU/mft/pca/LibCheck Wilamp DCU v2.0.pdf

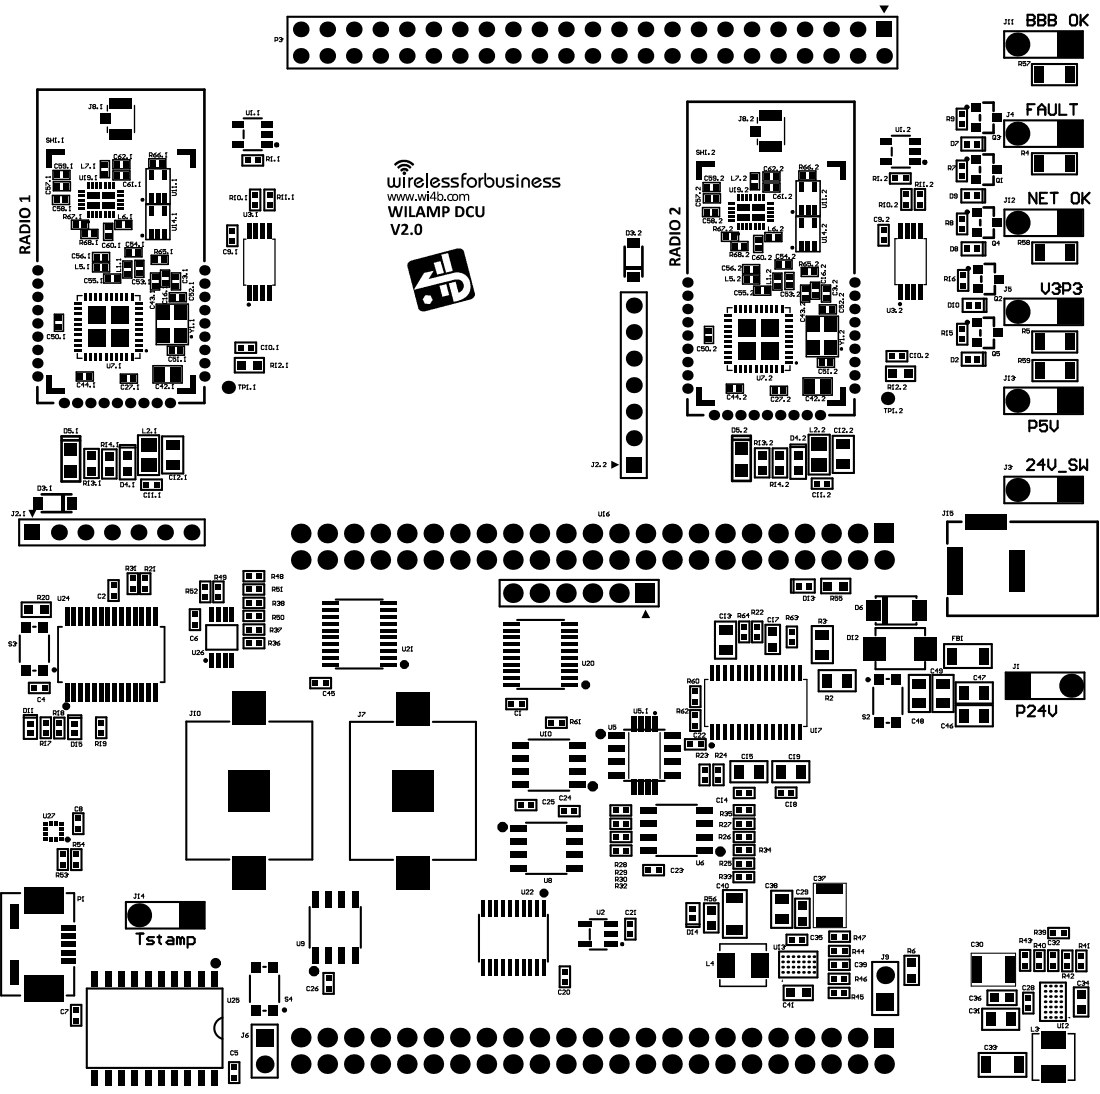
[picture p32: page 1]

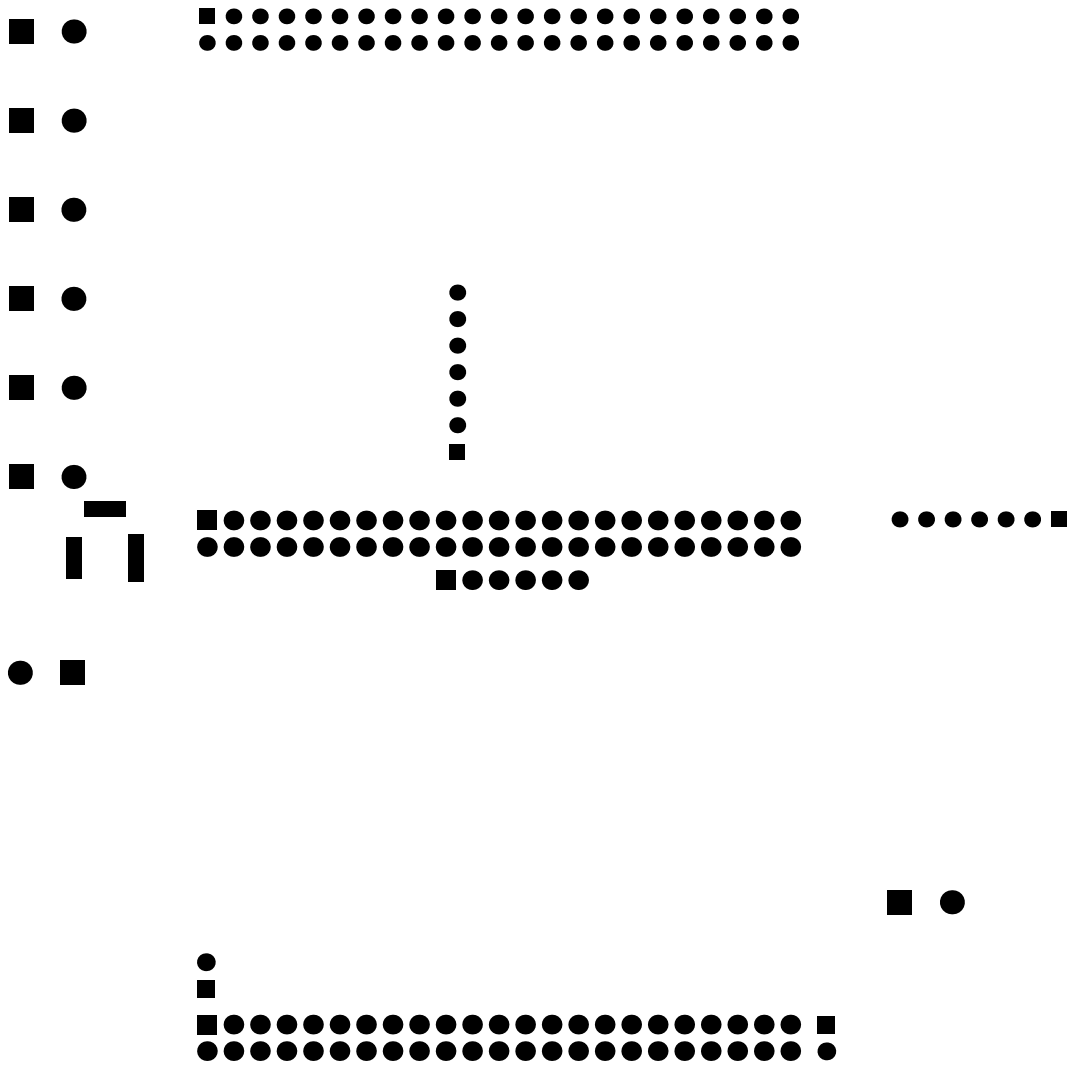
[picture p33: page 2]
