lbalucos/Wilamp_DCU/mft/pcb/Drill Wilamp DCU v2.0.pdf

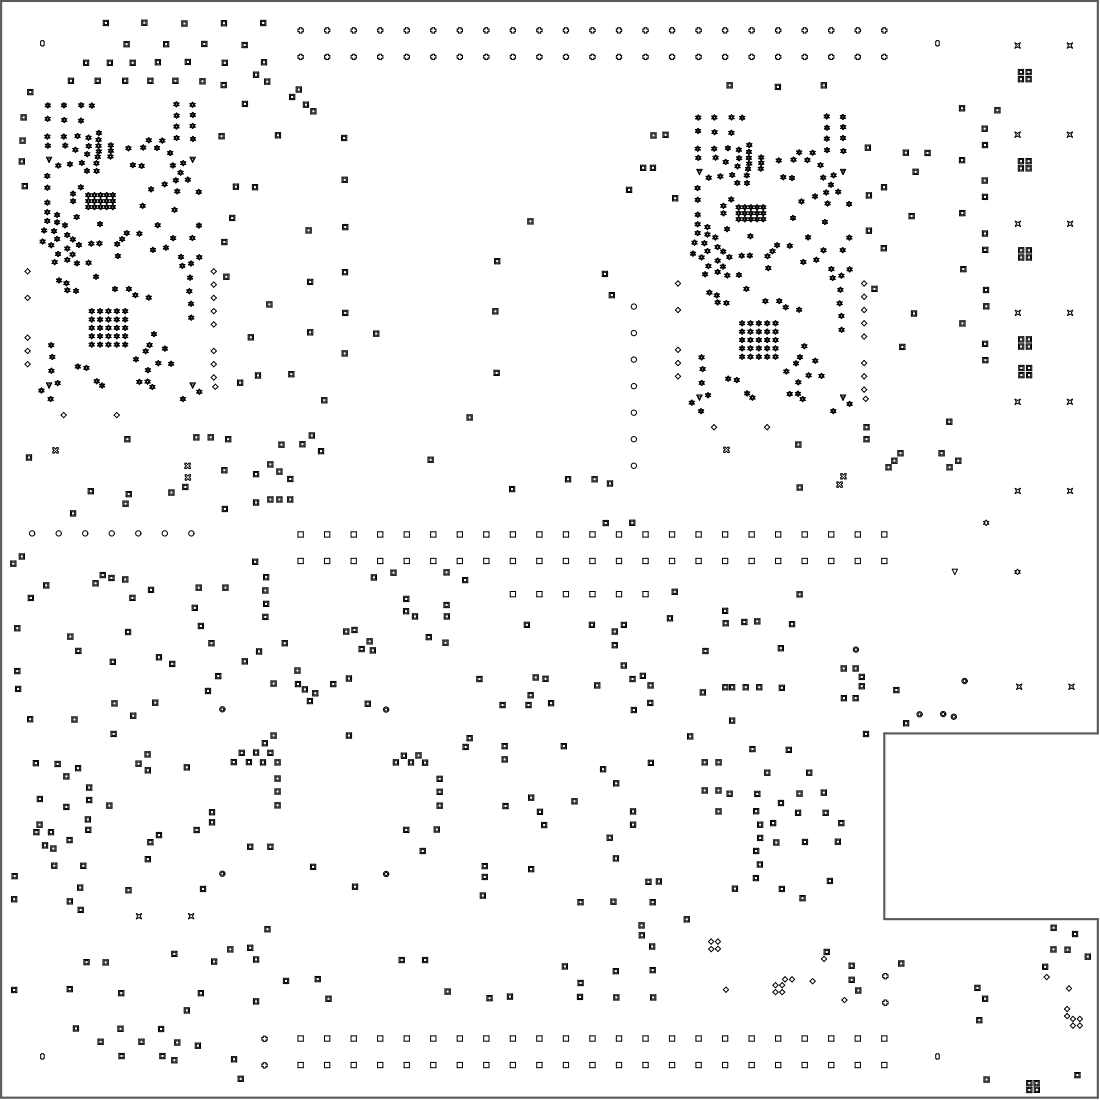
[picture p34: page 1]
