lbalucos/Wilamp_DCU/(list of files, drawings)

Other design files:
dsn/sch/3v3_dcdc_blk.SchDoc
dsn/sch/5v_dcdc_blk.SchDoc
dsn/sch/bbb_blk.SchDoc
dsn/sch/cover_page.SchDoc
dsn/sch/crypto_blk.SchDoc
dsn/sch/headerP3_blk.SchDoc
dsn/sch/JN5168.SchDoc
dsn/sch/JN5169.SchDoc
dsn/sch/LED.SchDoc
dsn/sch/Module_blk.SchDoc
dsn/sch/pic_blk.SchDoc
dsn/sch/PowerInFilter.SchDoc
dsn/sch/revision_history.SchDoc
dsn/sch/top_dsn.SchDoc
dsn/sch/USB_Mini.SchDoc
dsn/Wilamp_DCU.PrjPCB
local/dsn backup/sch/3v3_dcdc_blk.SchDoc
local/dsn backup/sch/5v_dcdc_blk.SchDoc
local/dsn backup/sch/bbb_blk.SchDoc
local/dsn backup/sch/cover_page.SchDoc
local/dsn backup/sch/crypto_blk.SchDoc
local/dsn backup/sch/headerP3_blk.SchDoc
local/dsn backup/sch/JN5168.SchDoc
local/dsn backup/sch/LED.SchDoc
local/dsn backup/sch/Module_blk.SchDoc
local/dsn backup/sch/pic_blk.SchDoc
local/dsn backup/sch/PowerInFilter.SchDoc
local/dsn backup/sch/revision_history.SchDoc
local/dsn backup/sch/top_dsn.SchDoc
local/dsn backup/sch/USB_Mini.SchDoc
local/dsn backup/Wilamp_DCU.PrjPCB
