lbalucos/Wilamp_DCU/(commit log)

2022-04-07 Wilamp DCU v1.1 base file
    Wilamp DCU v1.1 base file
    [3v3_dcdc_blk.SchDoc, 5v_dcdc_blk.SchDoc, JN5168.SchDoc, LED.SchDoc, PowerInFilter.SchDoc, USB_Mini.SchDoc, WI4B_Wilamp_PCB Stackup.xlsx, Wilamp DCU v1 20181227.xlsx]
2022-04-18 JN5168 module #3 and all its components removed, added double footprint for the component U5, replace the JN5168-M06 modules with the JN5169 chip, added ALT PN on all components used, removed compone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
    JN5168 module #3 and all its components removed,
    added double footprint for the component U5,
    replace the JN5168-M06 modules with the JN5169 chip,
    added ALT PN on all components used,
    removed components
    [3v3_dcdc_blk.SchDoc, 5v_dcdc_blk.SchDoc, JN5168.SchDoc, LED.SchDoc, Module_blk.SchDoc, PowerInFilter.SchDoc, USB_Mini.SchDoc, Wilamp DCU ALT MPN (no DNP).xlsx]
2022-04-19 Modified polygon pours, Fixed Design rule issues on PCB
    Modified polygon pours, Fixed Design rule issues on PCB
    [Wilamp_DCU.PrjPCB]
2022-04-22 alt pn list updated
    alt pn list updated
    [Wilamp DCU ALT MPN (no DNP).xlsx]
2022-04-22 NUD3124LT1G labeled as no stock
    NUD3124LT1G labeled as no stock
    [Wilamp DCU ALT MPN (no DNP).xlsx]
2022-04-28 Finalizing project, generating release files
    Finalizing project, generating release files
    [3v3_dcdc_blk.SchDoc, 5v_dcdc_blk.SchDoc, JN5168.SchDoc, JN5169.SchDoc, LED.SchDoc, Module_blk.SchDoc, PowerInFilter.SchDoc, USB_Mini.SchDoc]
2022-04-28 PCB stackup info updated
    PCB stackup info updated
    [WI4B_Wilamp_PCB Stackup.xlsx]
